rafael1193/TFG-heart-rate-monitor/img/portable-ecg.jpg

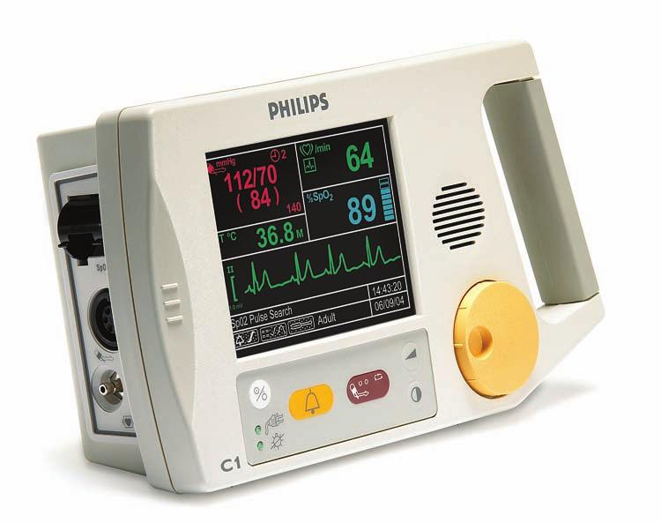
img/portable-ecg.jpg
