rafael1193/TFG-heart-rate-monitor/img/RN-42 bluetooth module-sin-fondo.jpg

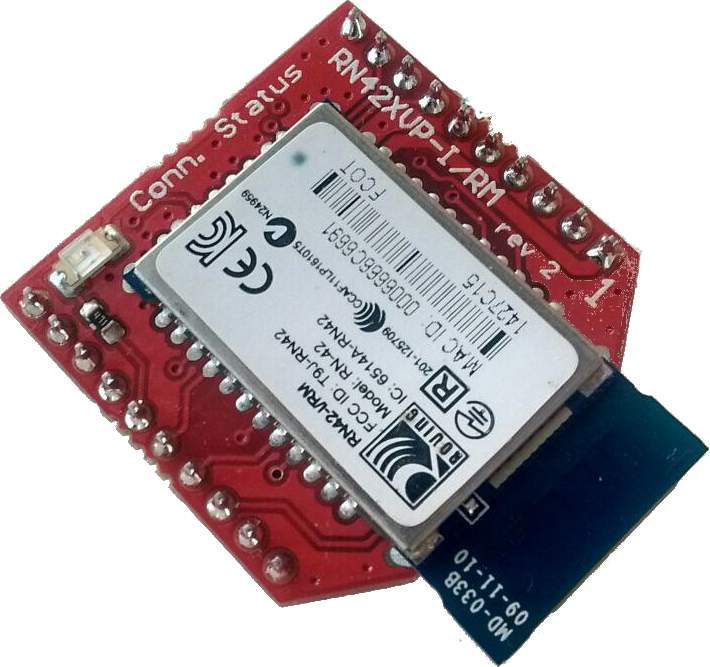
img/RN-42 bluetooth module-sin-fondo.jpg
