rafael1193/TFG-heart-rate-monitor/presentacion/presentacion.pdf

Trabajo Fin de Grado

## Diseño de un pulsómetro por infrarrojos

Rafael Bailón Ruiz

Tutor
Dr. Alberto J. Palma López

Cotutor
Fernando Martínez Martí

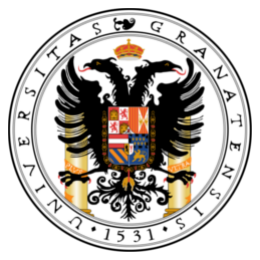
[picture p3: figure]

Departamento de Electrónica y Tecnología de Computadores Universidad de Granada

22 julio de 2015

Rafael Bailón Ruiz (UGR) | Pulsómetro por infrarrojos | 22 / 7 / 2015 | 1 / 44

## Índice

1 Introducción
2 Estado del Arte
Fundamento teórico
Medida de las pulsaciones
Dispositivos comerciales
3 Diseño y desarrollo del sistema Hardware
Firmware
Software
4 Resultados
Prueba de validación estática Prueba de validación dinámica 5 Conclusiones y trabajos futuros Conclusiones
Trabajos futuros
Rafael Bailón Ruiz (UGR) | Pulsómetro por infrarrojos | 22 / 7 / 2015 | 2 / 44

Introducción

## Conceptos clave

Rafael Bailón Ruiz (UGR) | Pulsómetro por infrarrojos | 22 / 7 / 2015 | 3 / 44

Introducción

## Conceptos clave

- Signos vitales:
- Temperatura corporal
- Frecuencia respiratoria
- Tensión arterial
- Frecuencia cardíaca
Rafael Bailón Ruiz (UGR) | Pulsómetro por infrarrojos | 22 / 7 / 2015 | 3 / 44

Introducción

## Conceptos clave

- Signos vitales:
- Temperatura corporal
- Frecuencia respiratoria
- Tensión arterial
- Frecuencia cardíaca

Pulsimetría

Método no invasivo de monitorización de la frecuencia cardíaca

Rafael Bailón Ruiz (UGR) | Pulsómetro por infrarrojos | 22 / 7 / 2015 | 3 / 44

Introducción

## Conceptos clave

- Signos vitales:
- Temperatura corporal
- Frecuencia respiratoria
- Tensión arterial
- Frecuencia cardíaca

Pulsimetría

Método no invasivo de monitorización de la frecuencia cardíaca

Fotopletismografía (PPG)

Representación de la variación volumétrica de las arterias obtenida mediante luz

Rafael Bailón Ruiz (UGR) | Pulsómetro por infrarrojos | 22 / 7 / 2015 | 3 / 44

Introducción

## Motivación

Rafael Bailón Ruiz (UGR) | Pulsómetro por infrarrojos | 22 / 7 / 2015 | 4 / 44

Introducción

## Motivación

- Aumento de las enfermedades crónicas
Rafael Bailón Ruiz (UGR) | Pulsómetro por infrarrojos | 22 / 7 / 2015 | 4 / 44

Introducción

## Motivación

- Aumento de las enfermedades crónicas
- Incremento de incidentes cardíacos inesperados
- Infarto
- Muerte súbita
Rafael Bailón Ruiz (UGR) | Pulsómetro por infrarrojos | 22 / 7 / 2015 | 4 / 44

Introducción

## Motivación

- Aumento de las enfermedades crónicas
- Incremento de incidentes cardíacos inesperados
- Infarto
- Muerte súbita
- Necesidad de monitorización fuera del recinto hospitalario (home care)
Rafael Bailón Ruiz (UGR) | Pulsómetro por infrarrojos | 22 / 7 / 2015 | 4 / 44

Introducción

## Motivación

- Aumento de las enfermedades crónicas
- Incremento de incidentes cardíacos inesperados
- Infarto
- Muerte súbita
- Necesidad de monitorización fuera del recinto hospitalario (home care)
- La instrumentación médica suele ser aparatosa y compleja de utilizar
Rafael Bailón Ruiz (UGR) | Pulsómetro por infrarrojos | 22 / 7 / 2015 | 4 / 44

Introducción

## Motivación

- Aumento de las enfermedades crónicas
- Incremento de incidentes cardíacos inesperados
- Infarto
- Muerte súbita
- Necesidad de monitorización fuera del recinto hospitalario (home care)
- La instrumentación médica suele ser aparatosa y compleja de utilizar
- Auge de los smartphones y wearable devices:
- Potencia
- Interfaz de usuario
- Conectividad
Rafael Bailón Ruiz (UGR) | Pulsómetro por infrarrojos | 22 / 7 / 2015 | 4 / 44

Introducción

## Objetivos

Rafael Bailón Ruiz (UGR) | Pulsómetro por infrarrojos | 22 / 7 / 2015 | 5 / 44

Introducción

## Objetivos

- Estudio bibliográco de las señales cardíacas y de dispositivos existentes para su medida.
Rafael Bailón Ruiz (UGR) | Pulsómetro por infrarrojos | 22 / 7 / 2015 | 5 / 44

Introducción

## Objetivos

- Estudio bibliográco de las señales cardíacas y de dispositivos existentes para su medida.
- Diseño y fabricación de un pulsómetro con sensor infrarrojo.
- Obtención del fotopletismograma.
- Procesado de la señal.
- Adquisición mediante un microcontrolador.
- Comunicación inalámbrica con un sistema monitorización.
- Diseño del sistema en placa de circuito impreso.
Rafael Bailón Ruiz (UGR) | Pulsómetro por infrarrojos | 22 / 7 / 2015 | 5 / 44

Introducción

## Objetivos

- Estudio bibliográco de las señales cardíacas y de dispositivos existentes para su medida.
- Diseño y fabricación de un pulsómetro con sensor infrarrojo.
- Obtención del fotopletismograma.
- Procesado de la señal.
- Adquisición mediante un microcontrolador.
- Comunicación inalámbrica con un sistema monitorización.
- Diseño del sistema en placa de circuito impreso.
- Diseño e implementación de una aplicación móvil para la monitorización remota del pulso cardíaco de un paciente.
Rafael Bailón Ruiz (UGR) | Pulsómetro por infrarrojos | 22 / 7 / 2015 | 5 / 44

Estado del Arte Fundamento teórico

## Índice

1 Introducción
2 Estado del Arte
Fundamento teórico
Medida de las pulsaciones
Dispositivos comerciales
3 Diseño y desarrollo del sistema Hardware
Firmware
Software
4 Resultados
Prueba de validación estática Prueba de validación dinámica 5 Conclusiones y trabajos futuros Conclusiones
Trabajos futuros
Rafael Bailón Ruiz (UGR) | Pulsómetro por infrarrojos | 22 / 7 / 2015 | 6 / 44

Estado del Arte Fundamento teórico

## Ciclo cardíaco

- Secuencia de eventos eléctricos, mecánicos, sonoros y de presión relacionados con el ujo de sangre a través de las cavidades cardíacas
Rafael Bailón Ruiz (UGR) | Pulsómetro por infrarrojos | 22 / 7 / 2015 | 7 / 44

Estado del Arte Fundamento teórico

## Ciclo cardíaco

- Secuencia de eventos eléctricos, mecánicos, sonoros y de presión relacionados con el ujo de sangre a través de las cavidades cardíacas
- Fases:
Rafael Bailón Ruiz (UGR) | Pulsómetro por infrarrojos | 22 / 7 / 2015 | 7 / 44

## Ciclo cardíaco

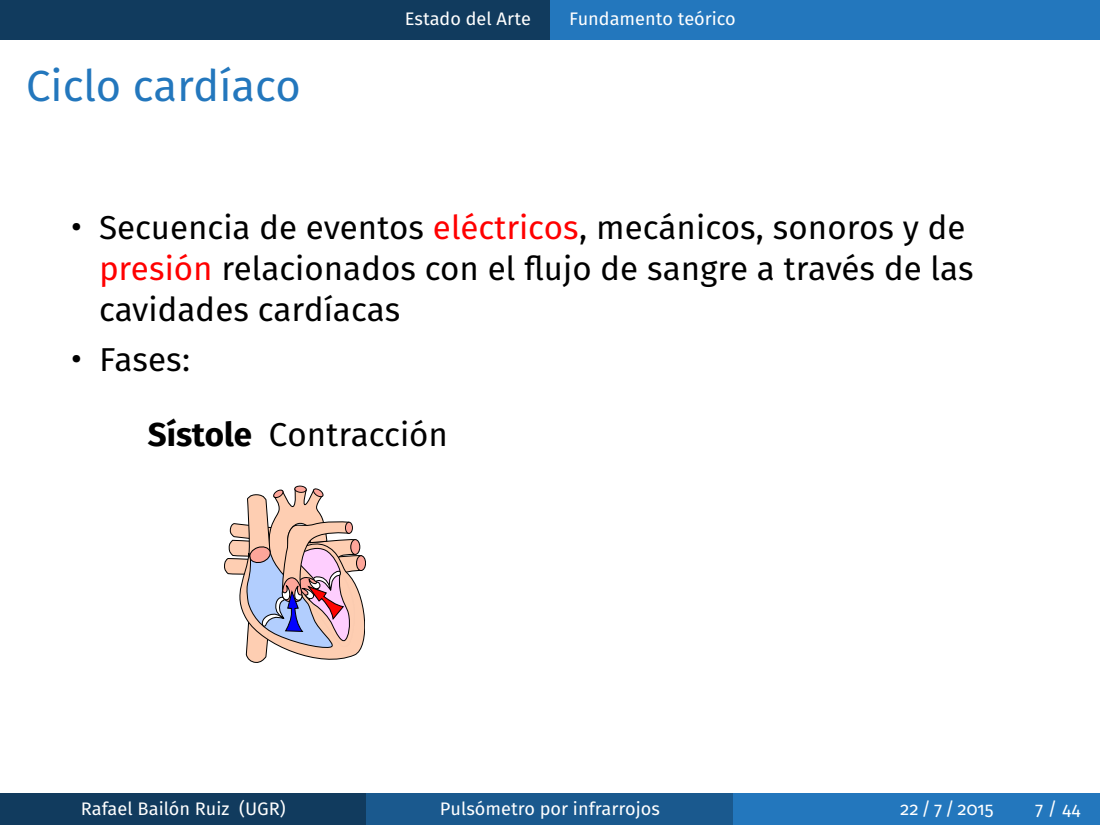
[picture p4: page 20]
Estado del Arte; Fundamento teórico; Sístole Contracción; Rafael Bailón Ruiz (UGR); Pulsómetro por infrarrojos

• Secuencia de eventos eléctricos, mecánicos, sonoros y de
presión relacionados con el ujo de sangre a través de las
cavidades cardíacas
• Fases:

## Ciclo cardíaco

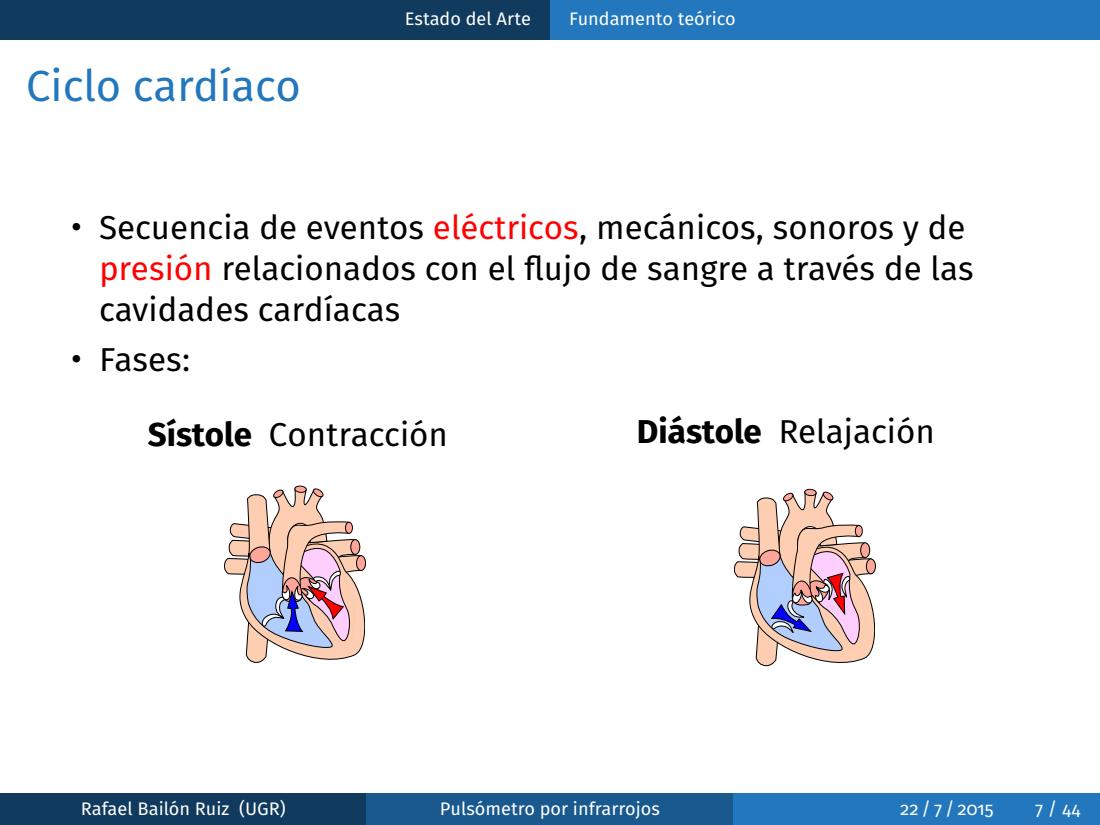
[picture p5: page 21]
Estado del Arte; Fundamento teórico; Sístole Contracción; Diástole Relajación; Rafael Bailón Ruiz (UGR); Pulsómetro por infrarrojos

• Secuencia de eventos eléctricos, mecánicos, sonoros y de
presión relacionados con el ujo de sangre a través de las
cavidades cardíacas
• Fases:

## Señales cardíacas

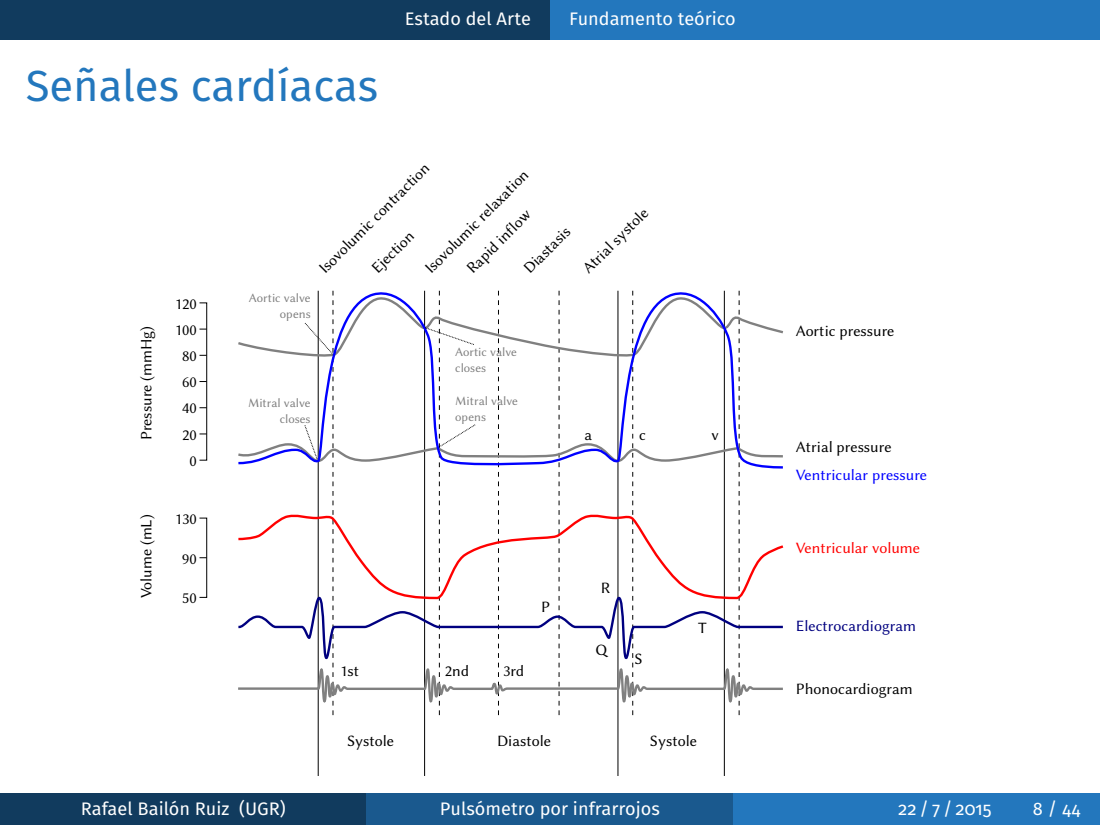
[picture p6: page 22]
Estado del Arte; Fundamento teórico; Isovolumic contraction; Ejection; Isovolumic relaxation; Rapid inflow Diastasis; Atrial systole; Aortic pressure; Atrial pressure; Ventricular pressure; Ventricular volume; Electrocardiogram; Phonocardiogram; Systole; Diastole; Pressure (mmHg); Volume (mL); Aortic valve opens; Aortic valve closes; Mitral valve closes; Mitral valve opens; Rafael Bailón Ruiz (UGR); Pulsómetro por infrarrojos

## ECG y PPG

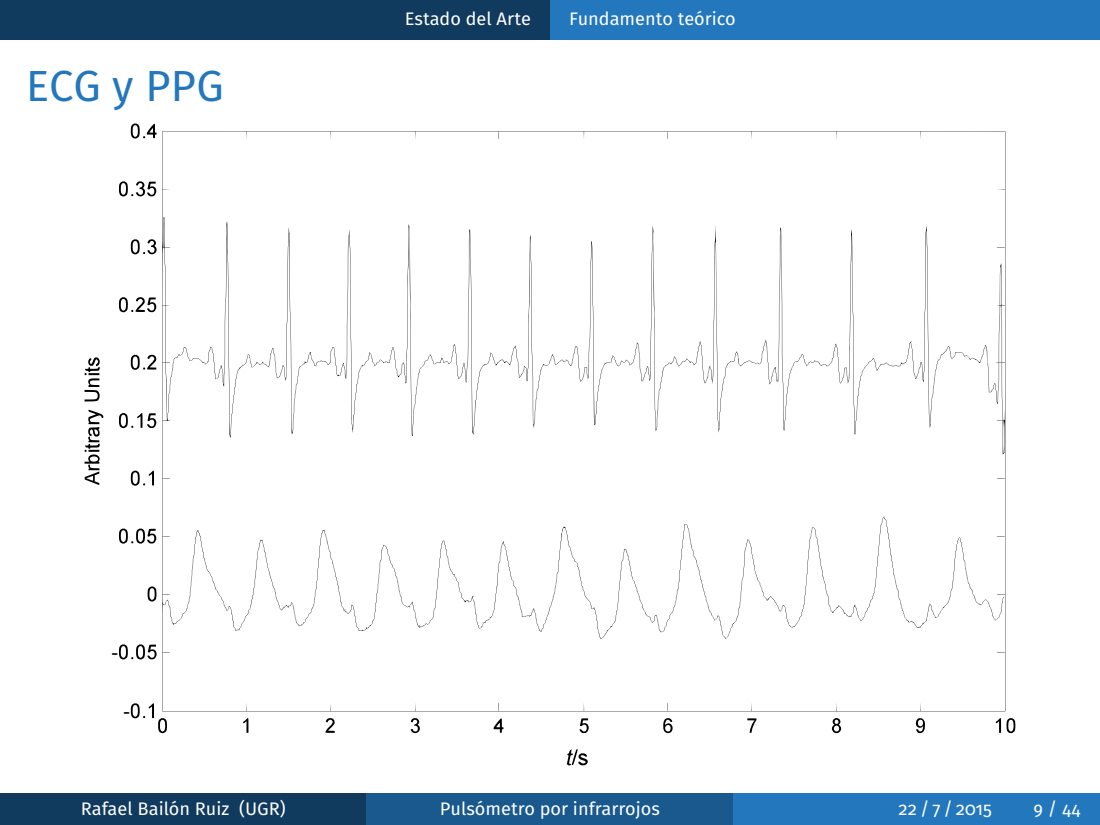
[picture p7: page 23]
Estado del Arte; Fundamento teórico; Rafael Bailón Ruiz (UGR); Pulsómetro por infrarrojos

Estado del Arte Medida de las pulsaciones

## Índice

1 Introducción
2 Estado del Arte
Fundamento teórico
Medida de las pulsaciones
Dispositivos comerciales
3 Diseño y desarrollo del sistema Hardware
Firmware
Software
4 Resultados
Prueba de validación estática Prueba de validación dinámica 5 Conclusiones y trabajos futuros Conclusiones
Trabajos futuros
Rafael Bailón Ruiz (UGR) | Pulsómetro por infrarrojos | 22 / 7 / 2015 | 10 / 44

Estado del Arte Medida de las pulsaciones

## Sensor fotopletismográco

- Registra la variación de la absorbancia de tejidos, órganos y uidos al ser iluminados
Rafael Bailón Ruiz (UGR) | Pulsómetro por infrarrojos | 22 / 7 / 2015 | 11 / 44

Estado del Arte Medida de las pulsaciones

## Sensor fotopletismográco

- Registra la variación de la absorbancia de tejidos, órganos y uidos al ser iluminados
- Compuesto por
Rafael Bailón Ruiz (UGR) | Pulsómetro por infrarrojos | 22 / 7 / 2015 | 11 / 44

Estado del Arte Medida de las pulsaciones

## Sensor fotopletismográco

- Registra la variación de la absorbancia de tejidos, órganos y uidos al ser iluminados
- Compuesto por
- Emisor: diodo
- Receptor: transistor o fotodiodo
- Rango de frecuencias: infrarrojo – rojo
Rafael Bailón Ruiz (UGR) | Pulsómetro por infrarrojos | 22 / 7 / 2015 | 11 / 44

Estado del Arte Medida de las pulsaciones

## Sensor fotopletismográco

- Registra la variación de la absorbancia de tejidos, órganos y uidos al ser iluminados
- Compuesto por
- Emisor: diodo
- Receptor: transistor o fotodiodo
- Rango de frecuencias: infrarrojo – rojo
Rafael Bailón Ruiz (UGR) | Pulsómetro por infrarrojos | 22 / 7 / 2015 | 11 / 44

Estado del Arte Medida de las pulsaciones

## Topología del sensor

Transmisión | Reexión

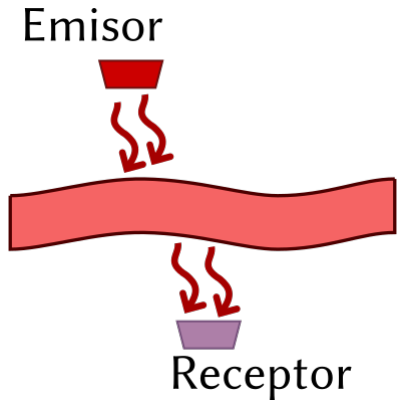
[picture p8: figure]
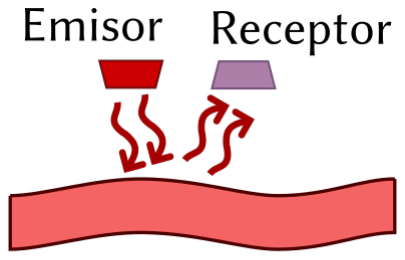
[picture p9: figure]

Rafael Bailón Ruiz (UGR) | Pulsómetro por infrarrojos | 22 / 7 / 2015 | 12 / 44

Estado del Arte Medida de las pulsaciones

## Componentes del PPG

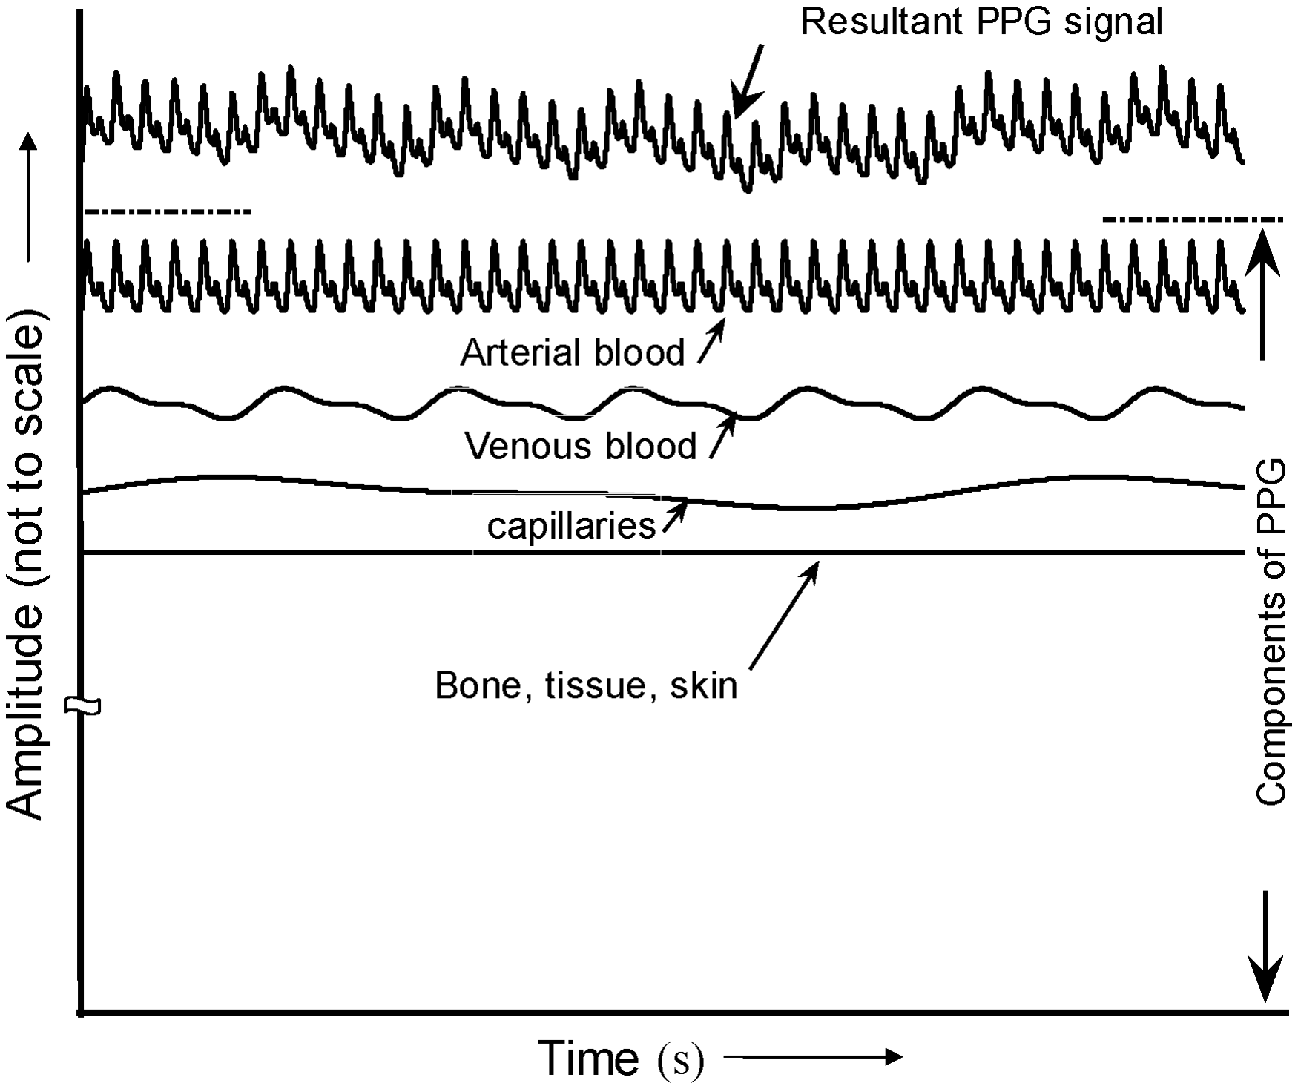
[picture p10: figure]

Rafael Bailón Ruiz (UGR) | Pulsómetro por infrarrojos | 22 / 7 / 2015 | 13 / 44

Estado del Arte Medida de las pulsaciones

## Pulsos

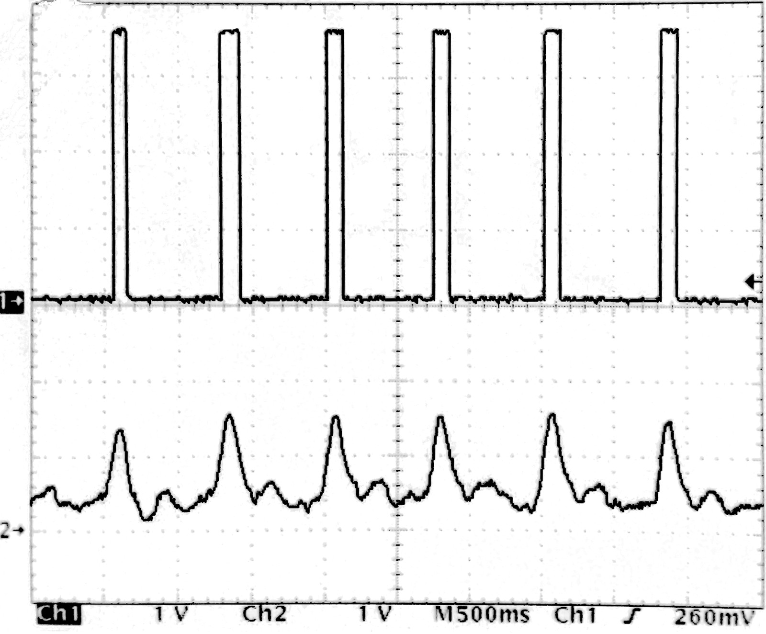
[picture p11: figure]

Rafael Bailón Ruiz (UGR) | Pulsómetro por infrarrojos | 22 / 7 / 2015 | 14 / 44

Estado del Arte Dispositivos comerciales

## Índice

1 Introducción
2 Estado del Arte
Fundamento teórico
Medida de las pulsaciones
Dispositivos comerciales
3 Diseño y desarrollo del sistema Hardware
Firmware
Software
4 Resultados
Prueba de validación estática Prueba de validación dinámica 5 Conclusiones y trabajos futuros Conclusiones
Trabajos futuros
Rafael Bailón Ruiz (UGR) | Pulsómetro por infrarrojos | 22 / 7 / 2015 | 15 / 44

Estado del Arte Dispositivos comerciales

## Pulsómetros ECG

Monitor ECG | Cardiofrecuencímetro

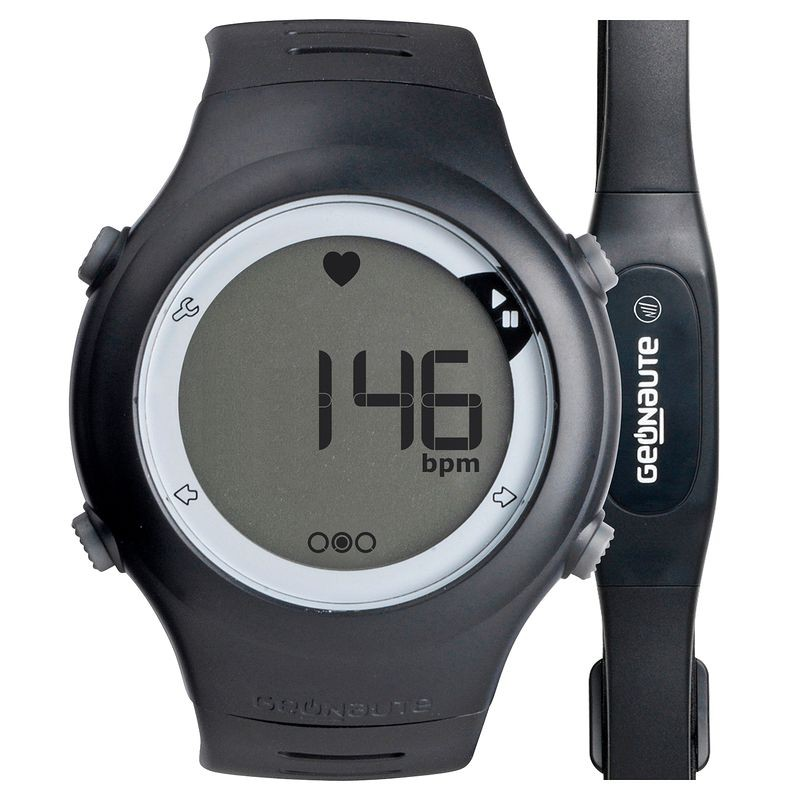
[picture p12: figure]

Rafael Bailón Ruiz (UGR) | Pulsómetro por infrarrojos | 22 / 7 / 2015 | 16 / 44

Estado del Arte Dispositivos comerciales

## Pulsómetros PPG

- Pulsera Fitbit
- FitBit Inc. >100 patentes sobre pulsómetros
vestibles
- Pulsera Samsung Gear
Fit
- Diseñada para
comunicación con
smartphone

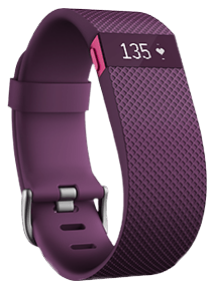
[picture p13: figure]
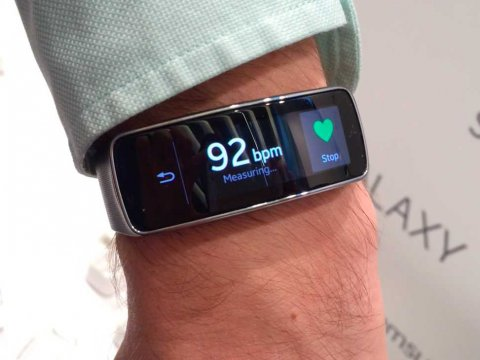
[picture p14: figure]

Rafael Bailón Ruiz (UGR) | Pulsómetro por infrarrojos | 22 / 7 / 2015 | 17 / 44

Estado del Arte Dispositivos comerciales

## Problema de los pulsómetros PPG

- Artefactos debidos al movimiento

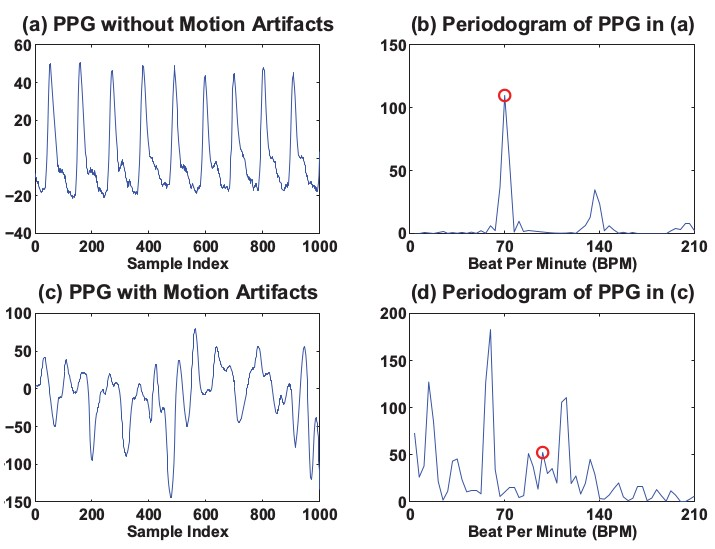
[picture p15: figure]

Rafael Bailón Ruiz (UGR) | Pulsómetro por infrarrojos | 22 / 7 / 2015 | 18 / 44

## Topología de los sensores

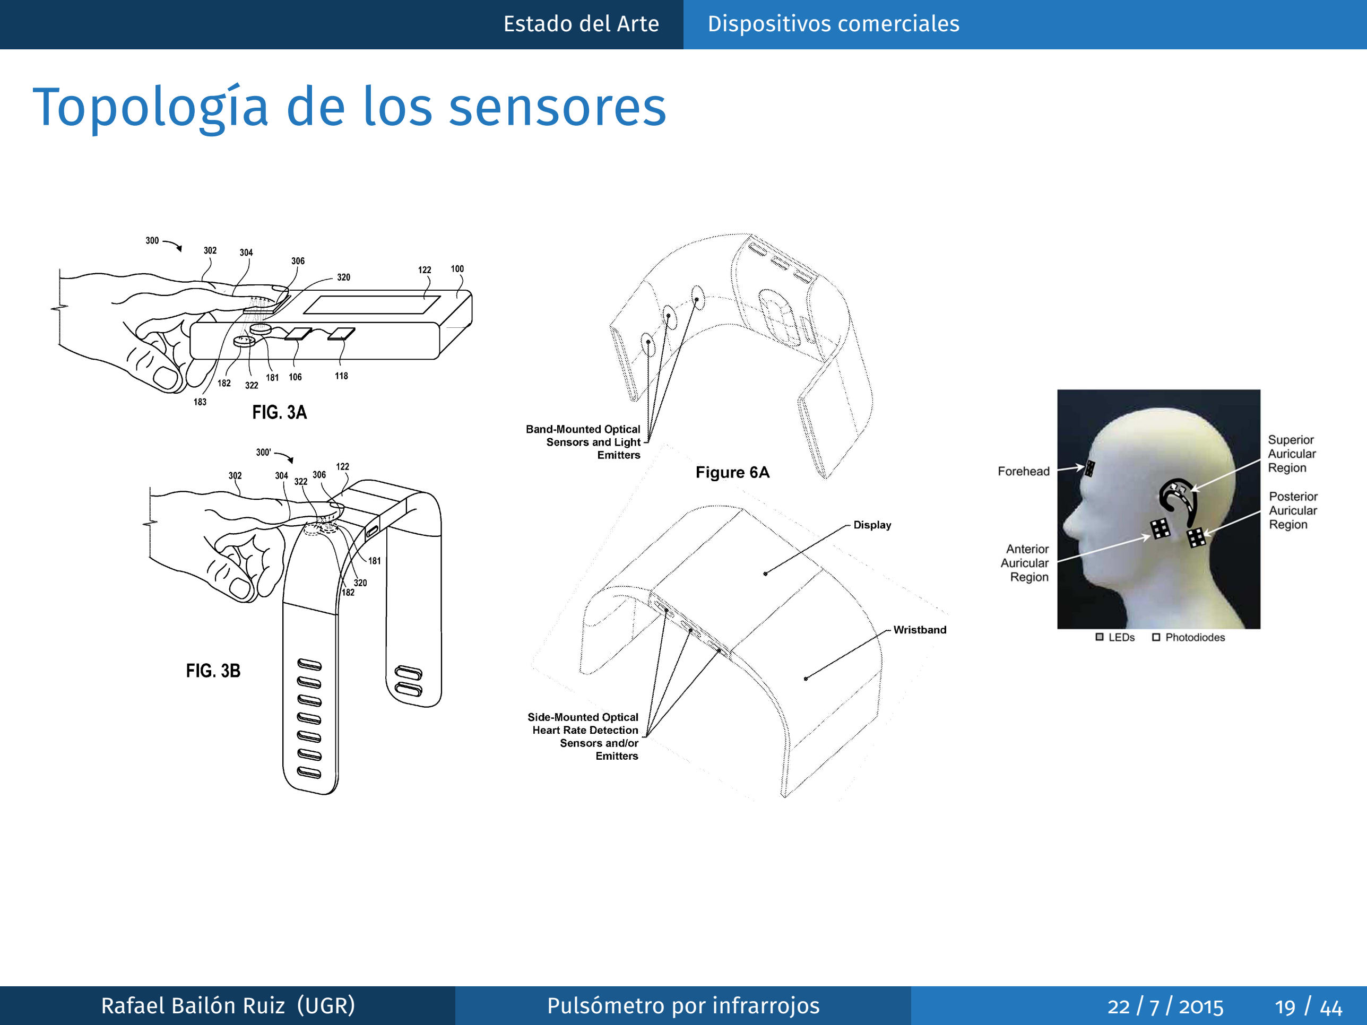
[picture p16: page 36]

Estado del Arte | Dispositivos comerciales
Rafael Bailón Ruiz (UGR) | Pulsómetro por infrarrojos | 22 / 7 / 2015 | 19 / 44

Diseño del sistema Hardware

## Índice

1 Introducción
2 Estado del Arte
Fundamento teórico
Medida de las pulsaciones
Dispositivos comerciales
3 Diseño y desarrollo del sistema Hardware
Firmware
Software
4 Resultados
Prueba de validación estática Prueba de validación dinámica 5 Conclusiones y trabajos futuros Conclusiones
Trabajos futuros
Rafael Bailón Ruiz (UGR) | Pulsómetro por infrarrojos | 22 / 7 / 2015 | 20 / 44

Diseño del sistema Hardware

## Diagrama

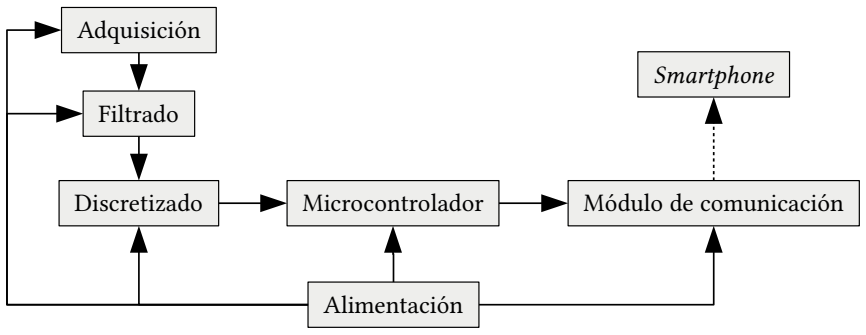
[picture p17: figure]
Discretizado; Microcontrolador; Alimentación; Módulo de comunicación; Smartphone; Adquisición; Filtrado

Rafael Bailón Ruiz (UGR) | Pulsómetro por infrarrojos | 22 / 7 / 2015 | 21 / 44

## Alimentación

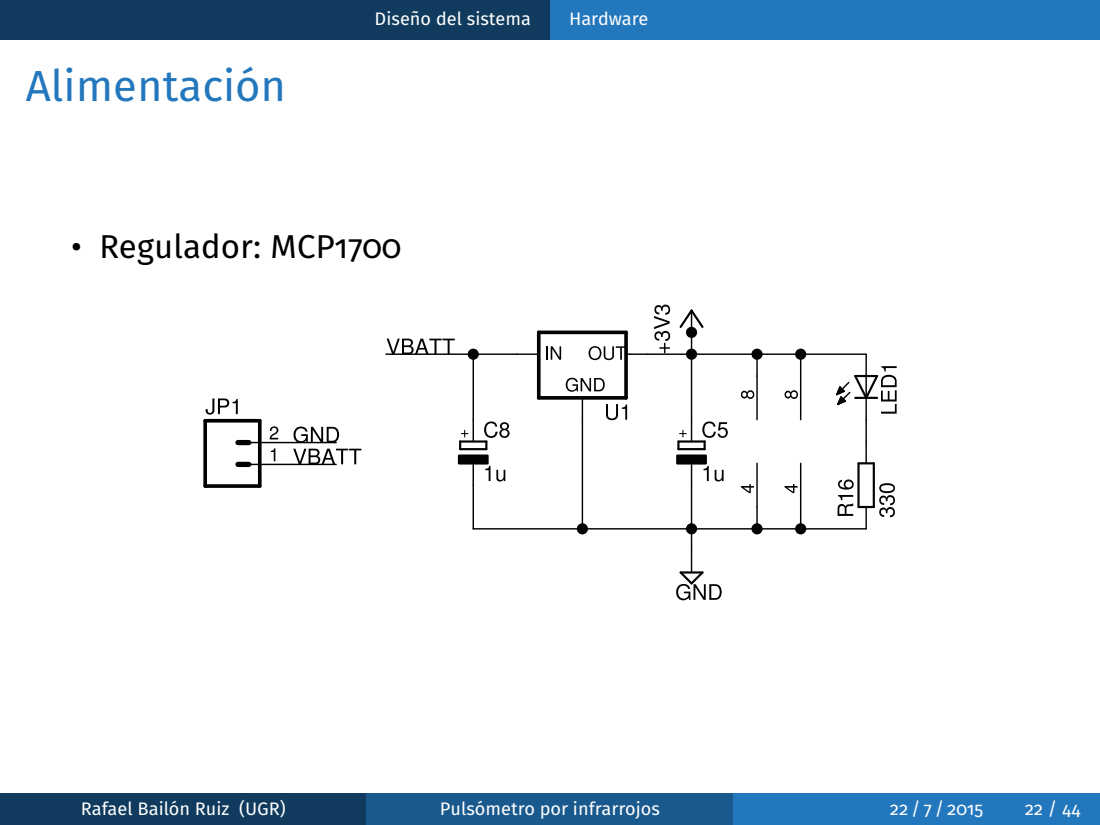
[picture p18: page 39]
Diseño del sistema; Hardware; • Regulador: MCP1700; Rafael Bailón Ruiz (UGR); Pulsómetro por infrarrojos

## Adquisición y procesado

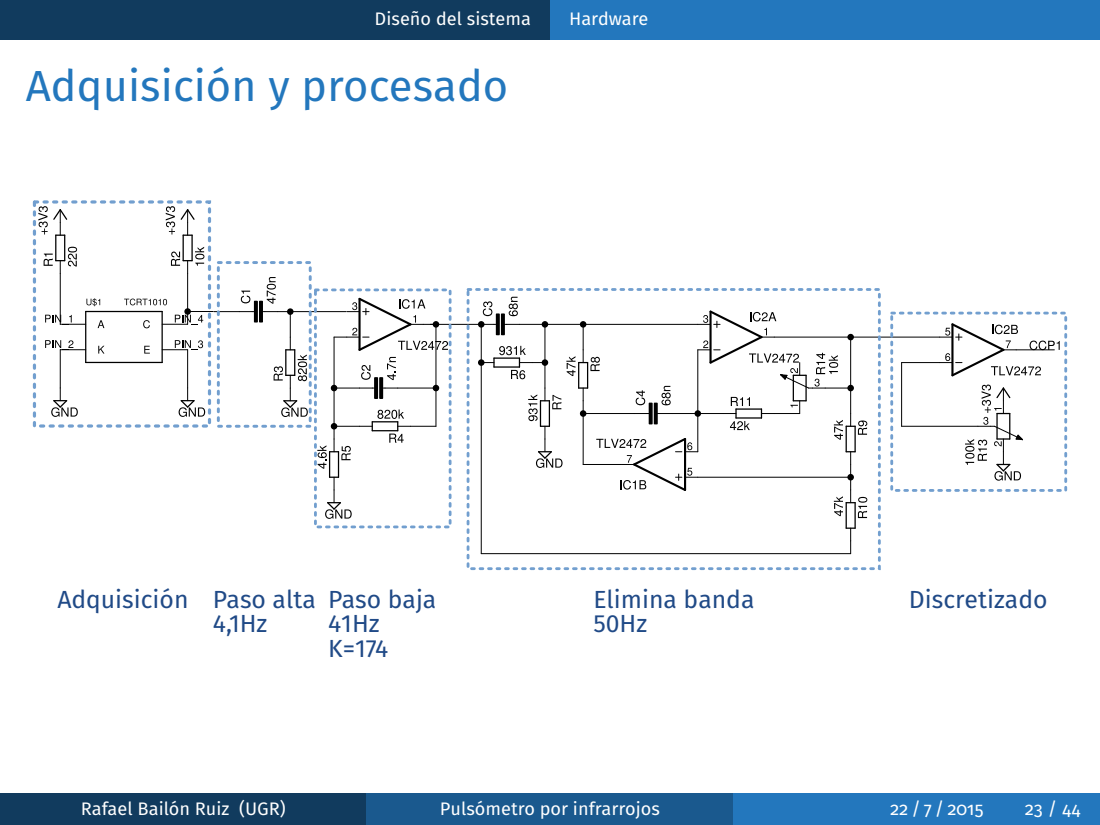
[picture p19: page 40]
Diseño del sistema; Hardware; Paso alta 4,1Hz; Paso baja 41Hz K=174; Elimina banda 50Hz; Adquisición; Discretizado; Rafael Bailón Ruiz (UGR); Pulsómetro por infrarrojos

## Microcontrolador y comunicación

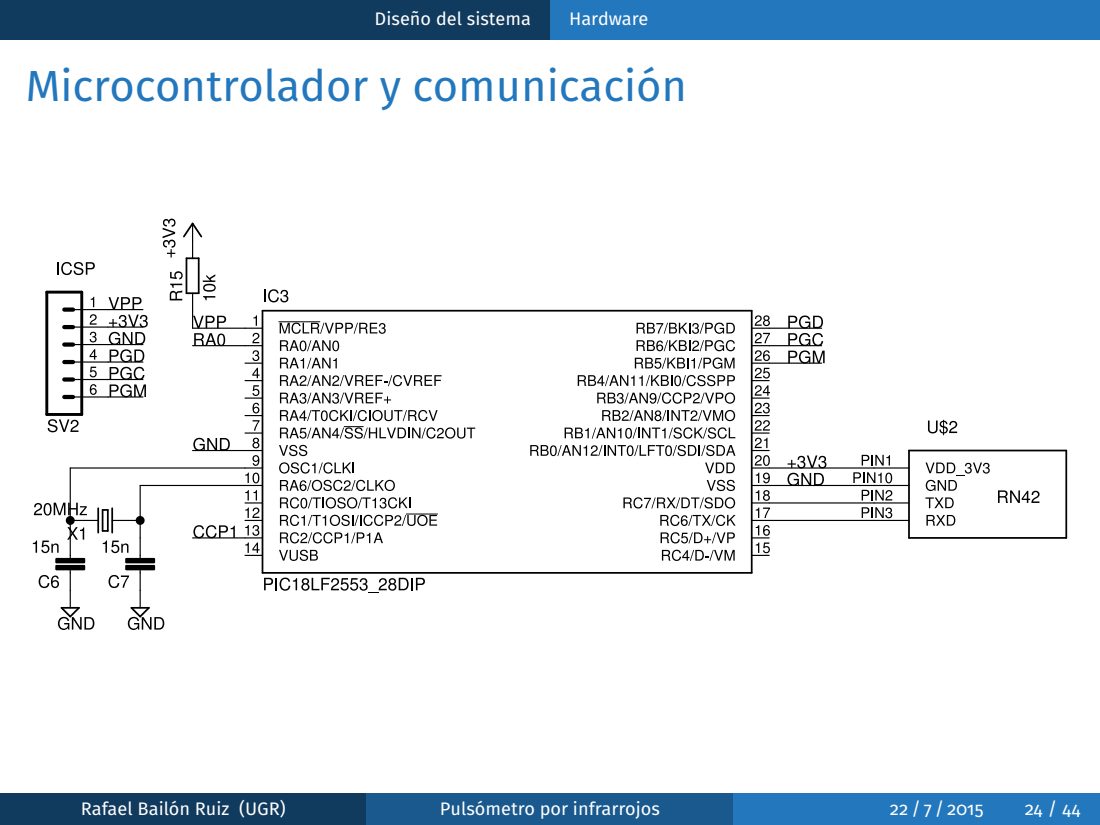
[picture p20: page 41]
Diseño del sistema; Hardware; Rafael Bailón Ruiz (UGR); Pulsómetro por infrarrojos

Diseño del sistema Firmware

## Índice

1 Introducción
2 Estado del Arte
Fundamento teórico
Medida de las pulsaciones
Dispositivos comerciales
3 Diseño y desarrollo del sistema Hardware
Firmware
Software
4 Resultados
Prueba de validación estática Prueba de validación dinámica 5 Conclusiones y trabajos futuros Conclusiones
Trabajos futuros
Rafael Bailón Ruiz (UGR) | Pulsómetro por infrarrojos | 22 / 7 / 2015 | 25 / 44

Diseño del sistema Firmware

## Manejo de interrupciones

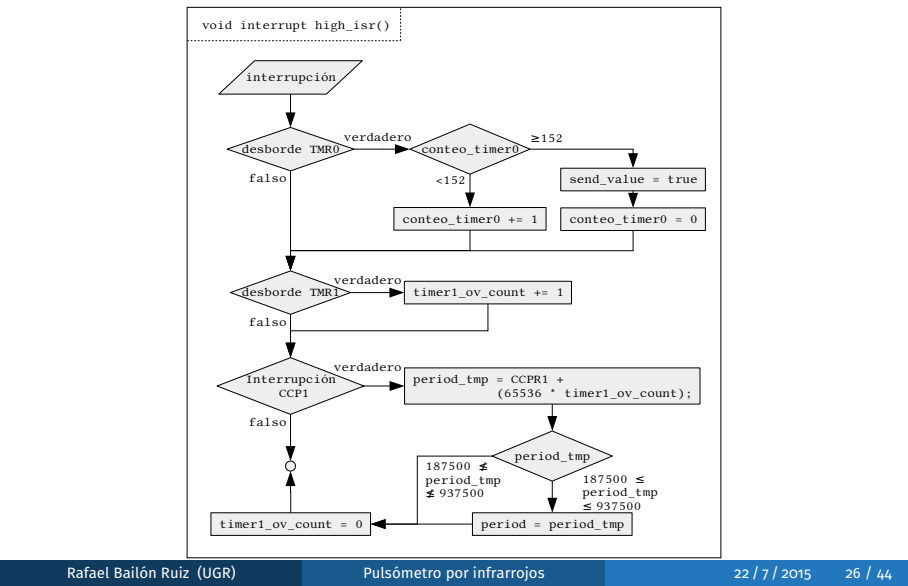
[picture p21: figure]
void interrupt high_isr(); desborde TMR0; verdadero; falso; desborde TMR1; Interrupción CCP1; conteo_timer0; send_value = true; conteo_timer0 = 0; interrupción; conteo_timer0 += 1; timer1_ov_count += 1; period_tmp = CCPR1 + (65536 * timer1_ov_count);; timer1_ov_count = 0; period_tmp; period = period_tmp; 187500 ≤ period_tmp ≤ 937500; 187500 ≰ period_tmp ≰ 937500; Rafael Bailón Ruiz (UGR); Pulsómetro por infrarrojos

Diseño del sistema Firmware

## Función principal

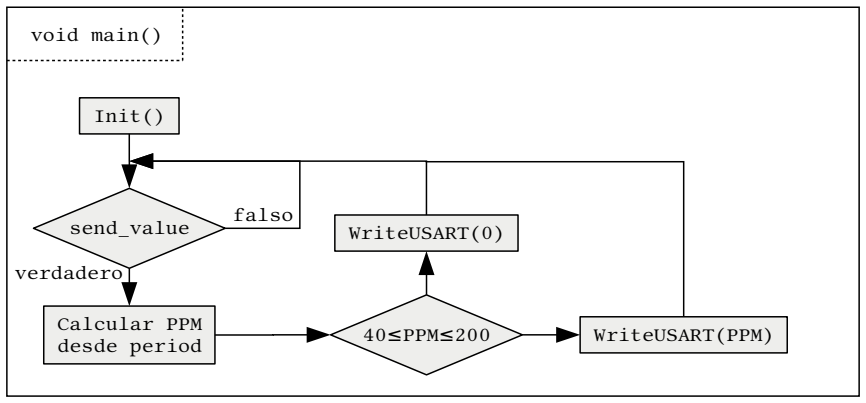
[picture p22: figure]
void main(); Init(); send_value; Calcular PPM; desde period; 40≤PPM≤200; WriteUSART(PPM); WriteUSART(0); verdadero; falso

Rafael Bailón Ruiz (UGR) | Pulsómetro por infrarrojos | 22 / 7 / 2015 | 27 / 44

Diseño del sistema Software

## Índice

1 Introducción
2 Estado del Arte
Fundamento teórico
Medida de las pulsaciones
Dispositivos comerciales
3 Diseño y desarrollo del sistema Hardware
Firmware
Software
4 Resultados
Prueba de validación estática Prueba de validación dinámica 5 Conclusiones y trabajos futuros Conclusiones
Trabajos futuros
Rafael Bailón Ruiz (UGR) | Pulsómetro por infrarrojos | 22 / 7 / 2015 | 28 / 44

## Aplicación Android

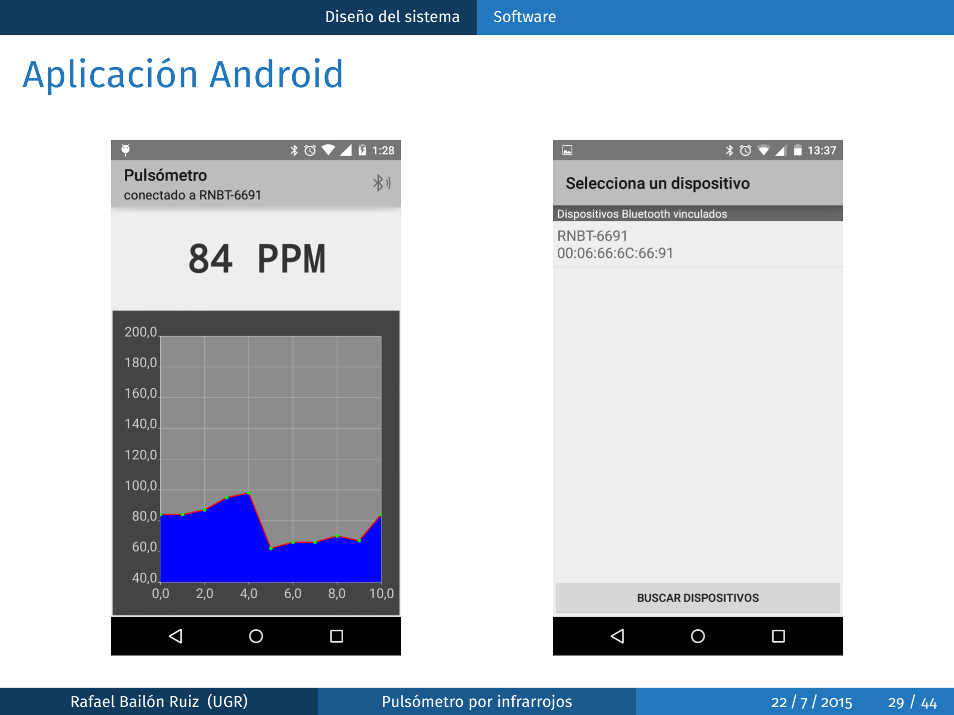
[picture p23: page 46]

Diseño del sistema | Software
Rafael Bailón Ruiz (UGR) | Pulsómetro por infrarrojos | 22 / 7 / 2015 | 29 / 44

Resultados

## Pulsómetro en funcionamiento

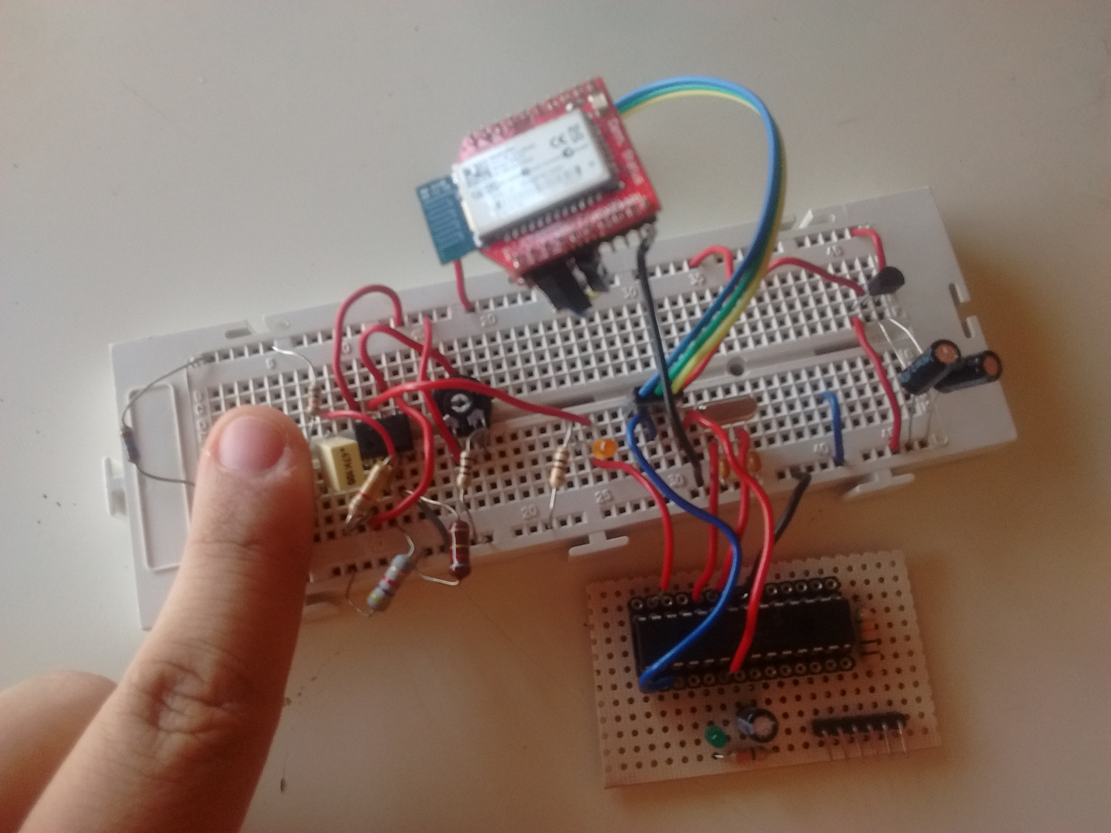
[picture p24: figure]

Rafael Bailón Ruiz (UGR) | Pulsómetro por infrarrojos | 22 / 7 / 2015 | 30 / 44

Resultados Prueba estática

## Índice

1 Introducción
2 Estado del Arte
Fundamento teórico
Medida de las pulsaciones
Dispositivos comerciales
3 Diseño y desarrollo del sistema Hardware
Firmware
Software
4 Resultados
Prueba de validación estática Prueba de validación dinámica 5 Conclusiones y trabajos futuros Conclusiones
Trabajos futuros
Rafael Bailón Ruiz (UGR) | Pulsómetro por infrarrojos | 22 / 7 / 2015 | 31 / 44

Resultados Prueba estática

## Condiciones de test

Rafael Bailón Ruiz (UGR) | Pulsómetro por infrarrojos | 22 / 7 / 2015 | 32 / 44

Resultados Prueba estática

## Condiciones de test

- Toma de pulsaciones en reposo
Rafael Bailón Ruiz (UGR) | Pulsómetro por infrarrojos | 22 / 7 / 2015 | 32 / 44

Resultados Prueba estática

## Condiciones de test

- Toma de pulsaciones en reposo
- Sujeto:
- Varón
- Atleta veterano
- 54 años
Rafael Bailón Ruiz (UGR) | Pulsómetro por infrarrojos | 22 / 7 / 2015 | 32 / 44

Resultados Prueba estática

## Condiciones de test

- Toma de pulsaciones en reposo
- Sujeto:
- Varón
- Atleta veterano
- 54 años
- Validación de los datos:
- Comparación con cardiofrecuencímetro comercial basado en ECG
Rafael Bailón Ruiz (UGR) | Pulsómetro por infrarrojos | 22 / 7 / 2015 | 32 / 44

Resultados Prueba estática

## Resultados

Pulsómetro | Cardiofrecuencímetro
Promedio pulsaciones [PPM] | 70 | 69
Desviación estándar | 4,01 | 1,90
g | 8 | 8
n | 9 | 9
t student (0,9950) | 3,355 | 3,355
Error absoluto | ±4,49 | ±2,12
Rafael Bailón Ruiz (UGR) | Pulsómetro por infrarrojos | 22 / 7 / 2015 | 33 / 44

Resultados Prueba dinámica

## Índice

1 Introducción
2 Estado del Arte
Fundamento teórico
Medida de las pulsaciones
Dispositivos comerciales
3 Diseño y desarrollo del sistema Hardware
Firmware
Software
4 Resultados
Prueba de validación estática Prueba de validación dinámica 5 Conclusiones y trabajos futuros Conclusiones
Trabajos futuros
Rafael Bailón Ruiz (UGR) | Pulsómetro por infrarrojos | 22 / 7 / 2015 | 34 / 44

Resultados Prueba dinámica

## Condiciones de test

- Toma de pulsaciones durante el periodo de recuperación tras sesión de ejercicio
Rafael Bailón Ruiz (UGR) | Pulsómetro por infrarrojos | 22 / 7 / 2015 | 35 / 44

Resultados Prueba dinámica

## Condiciones de test

- Toma de pulsaciones durante el periodo de recuperación tras sesión de ejercicio
- Sujeto:
- Varón
- Atleta veterano
- 54 años
Rafael Bailón Ruiz (UGR) | Pulsómetro por infrarrojos | 22 / 7 / 2015 | 35 / 44

Resultados Prueba dinámica

## Condiciones de test

- Toma de pulsaciones durante el periodo de recuperación tras sesión de ejercicio
- Sujeto:
- Varón
- Atleta veterano
- 54 años
- Validación de los datos:
- Comparación con cardiofrecuencímetro comercial basado en ECG
Rafael Bailón Ruiz (UGR) | Pulsómetro por infrarrojos | 22 / 7 / 2015 | 35 / 44

Resultados Prueba dinámica

## Resultados

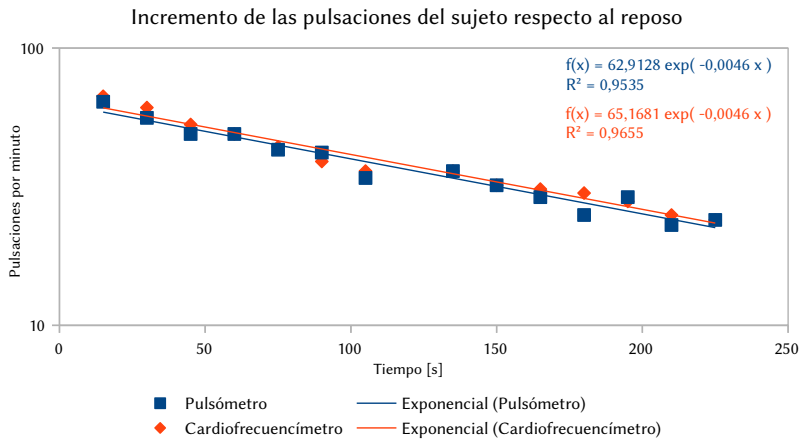
[picture p25: figure]
f(x) = 65,1681 exp( -0,0046 x ) R² = 0,9655; f(x) = 62,9128 exp( -0,0046 x ) R² = 0,9535; Pulsómetro; Exponencial (Pulsómetro); Cardiofrecuencímetro; Exponencial (Cardiofrecuencímetro); Tiempo [s]; Pulsaciones por minuto

Incremento de las pulsaciones del sujeto respecto al reposo

Rafael Bailón Ruiz (UGR) | Pulsómetro por infrarrojos | 22 / 7 / 2015 | 36 / 44

Resultados Prueba dinámica

## Resultados

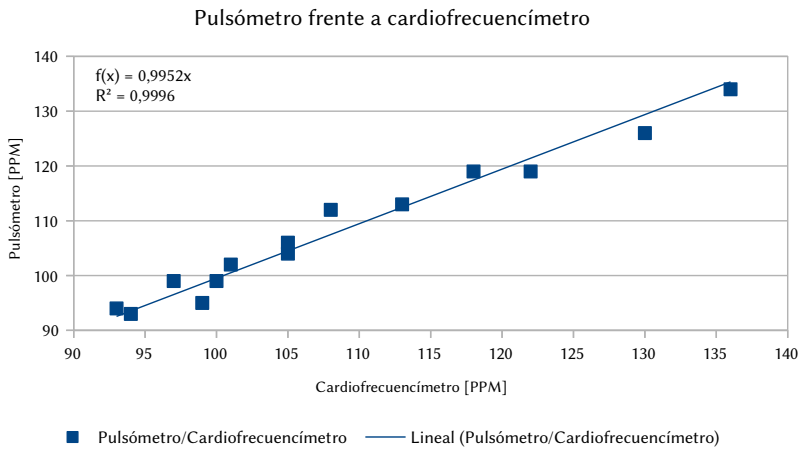
[picture p26: figure]
Pulsómetro frente a cardiofrecuencímetro; Pulsómetro/Cardiofrecuencímetro; Lineal (Pulsómetro/Cardiofrecuencímetro); Cardiofrecuencímetro [PPM]; Pulsómetro [PPM]

Rafael Bailón Ruiz (UGR) | Pulsómetro por infrarrojos | 22 / 7 / 2015 | 37 / 44

Conclusiones y trabajos futuros Conclusiones

## Índice

1 Introducción
2 Estado del Arte
Fundamento teórico
Medida de las pulsaciones
Dispositivos comerciales
3 Diseño y desarrollo del sistema Hardware
Firmware
Software
4 Resultados
Prueba de validación estática Prueba de validación dinámica 5 Conclusiones y trabajos futuros Conclusiones
Trabajos futuros
Rafael Bailón Ruiz (UGR) | Pulsómetro por infrarrojos | 22 / 7 / 2015 | 38 / 44

Conclusiones y trabajos futuros Conclusiones

## Conclusiones

- El estudio del estado del arte ha revelado las posibilidades de la pulsimetría basada en PPG
Rafael Bailón Ruiz (UGR) | Pulsómetro por infrarrojos | 22 / 7 / 2015 | 39 / 44

Conclusiones y trabajos futuros Conclusiones

## Conclusiones

- El estudio del estado del arte ha revelado las posibilidades de la pulsimetría basada en PPG
- La comunicación inalámbrica y los smartphones facilitan el uso de la instrumentación médica
Rafael Bailón Ruiz (UGR) | Pulsómetro por infrarrojos | 22 / 7 / 2015 | 39 / 44

Conclusiones y trabajos futuros Conclusiones

## Conclusiones

- El estudio del estado del arte ha revelado las posibilidades de la pulsimetría basada en PPG
- La comunicación inalámbrica y los smartphones facilitan el uso de la instrumentación médica
- Comprobación del funcionamiento del pulsómetro diseñado
Rafael Bailón Ruiz (UGR) | Pulsómetro por infrarrojos | 22 / 7 / 2015 | 39 / 44

Conclusiones y trabajos futuros Trabajos futuros

## Índice

1 Introducción
2 Estado del Arte
Fundamento teórico
Medida de las pulsaciones
Dispositivos comerciales
3 Diseño y desarrollo del sistema Hardware
Firmware
Software
4 Resultados
Prueba de validación estática Prueba de validación dinámica 5 Conclusiones y trabajos futuros Conclusiones
Trabajos futuros
Rafael Bailón Ruiz (UGR) | Pulsómetro por infrarrojos | 22 / 7 / 2015 | 40 / 44

Conclusiones y trabajos futuros Trabajos futuros

## Trabajos futuros

- Pasar del montaje experimental al producto nal
Rafael Bailón Ruiz (UGR) | Pulsómetro por infrarrojos | 22 / 7 / 2015 | 41 / 44

Conclusiones y trabajos futuros Trabajos futuros

## Trabajos futuros

- Pasar del montaje experimental al producto nal
- Mejorar la topología del sensor fotopletismográco
Rafael Bailón Ruiz (UGR) | Pulsómetro por infrarrojos | 22 / 7 / 2015 | 41 / 44

Conclusiones y trabajos futuros Trabajos futuros

## Trabajos futuros

- Pasar del montaje experimental al producto nal
- Mejorar la topología del sensor fotopletismográco
- Ampliar funcionalidad de la aplicación
- Portar a otros sistema operativos
- Más opciones de conguración y personalización
Rafael Bailón Ruiz (UGR) | Pulsómetro por infrarrojos | 22 / 7 / 2015 | 41 / 44

Apéndice Bibliografía fundamental

## Referencias I

Ramlee, R.A. et al.
Low cost heart rate monitoring device using Bluetooth 2014 2nd International Conference on Information and Communication Technology (ICoICT). 42–46, 2014.

Venkatraman, S.
Wearable heart rate monitor
United States Patent: 8945017. February 3, 2015.

Zhang, Z.
Heart rate monitoring from wrist-type photoplethysmographic (PPG) signals during intensive physical exercise
2014 IEEE Global Conference on Signal and Information Processing (GlobalSIP). 698–702, 2014.
Rafael Bailón Ruiz (UGR) | Pulsómetro por infrarrojos | 22 / 7 / 2015 | 42 / 44

Apéndice Bibliografía fundamental

## Referencias II

1
Thesis Defense de Randall Munroe traducido por Gabriel Rodríguez Alberich, disponible bajo la licencia CC BY-NC 2.0 http://es.xkcd.com/strips/defensa-de-tesis/

Referencias a las imágenes y diagramas en la memoria.

Rafael Bailón Ruiz (UGR) | Pulsómetro por infrarrojos | 22 / 7 / 2015 | 43 / 44

Apéndice Final

## ¡Gracias por su atención!

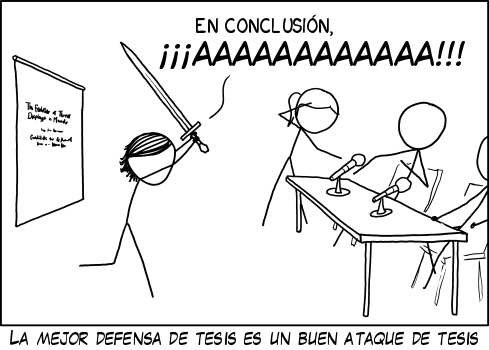
[picture p27: figure]

1

Contenido disponible en
https://github.com/rafael1193/TFG-heart-rate-monitor
Rafael Bailón Ruiz (UGR) | Pulsómetro por infrarrojos | 22 / 7 / 2015 | 44 / 44
