rafael1193/TFG-heart-rate-monitor/img/app-activar_bluetooth.png

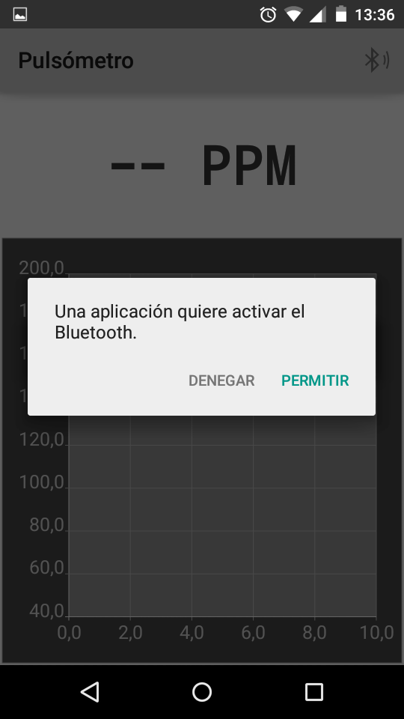
img/app-activar_bluetooth.png
