rafael1193/TFG-heart-rate-monitor/img/app-buscando.png

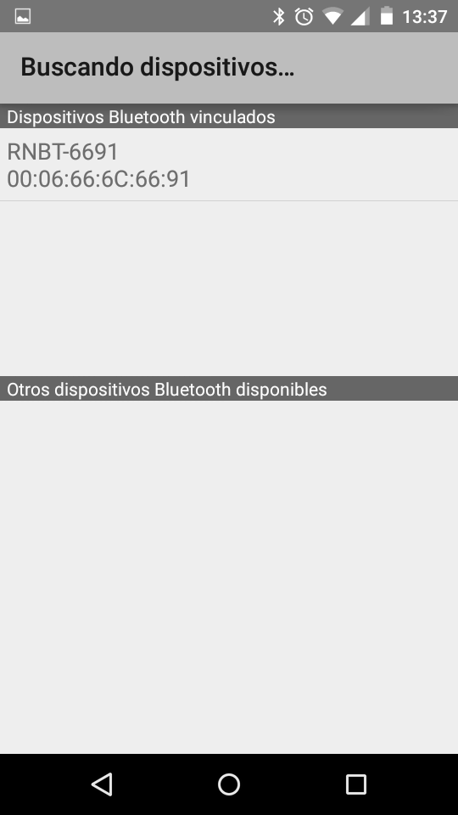
img/app-buscando.png
