rafael1193/TFG-heart-rate-monitor/img/app-midiendo.png

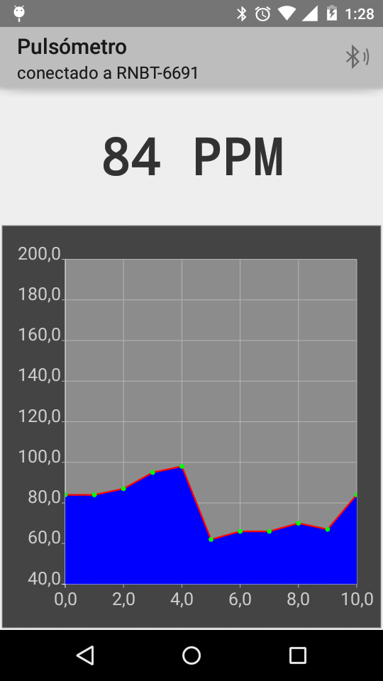
img/app-midiendo.png
