rafael1193/TFG-heart-rate-monitor/img/app-midiendo_sin_promedio.png

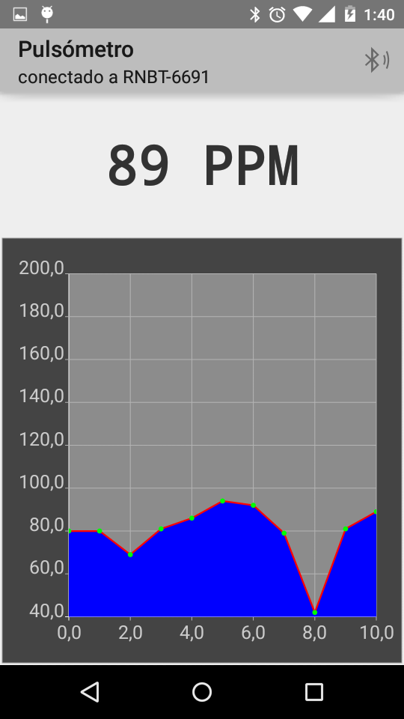
img/app-midiendo_sin_promedio.png
