rafael1193/TFG-heart-rate-monitor/img/app-no_encontrados.png

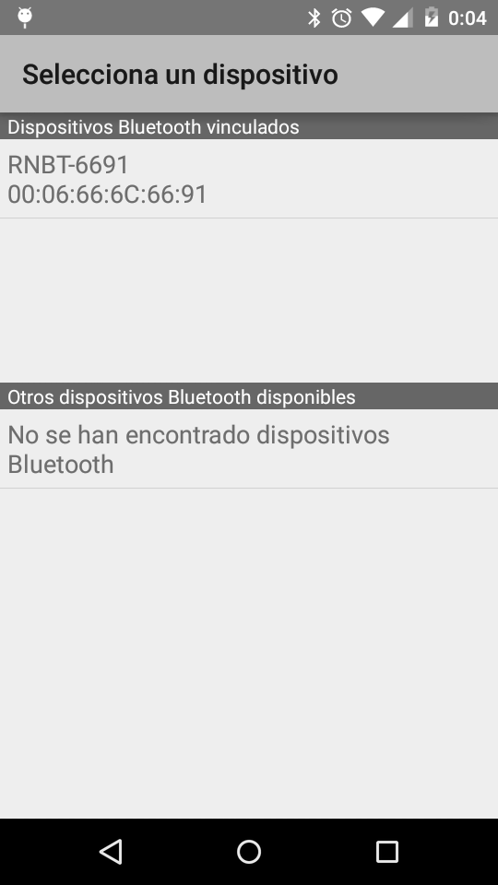
img/app-no_encontrados.png
