rafael1193/TFG-heart-rate-monitor/img/app-vista_bluetooth.png

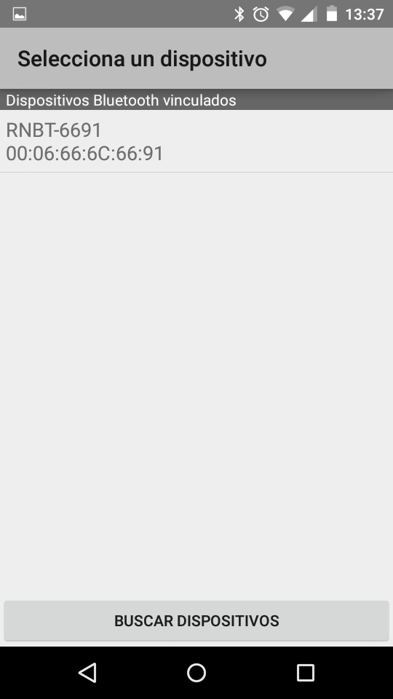
img/app-vista_bluetooth.png
