rafael1193/TFG-heart-rate-monitor/img/apple-watch.jpg

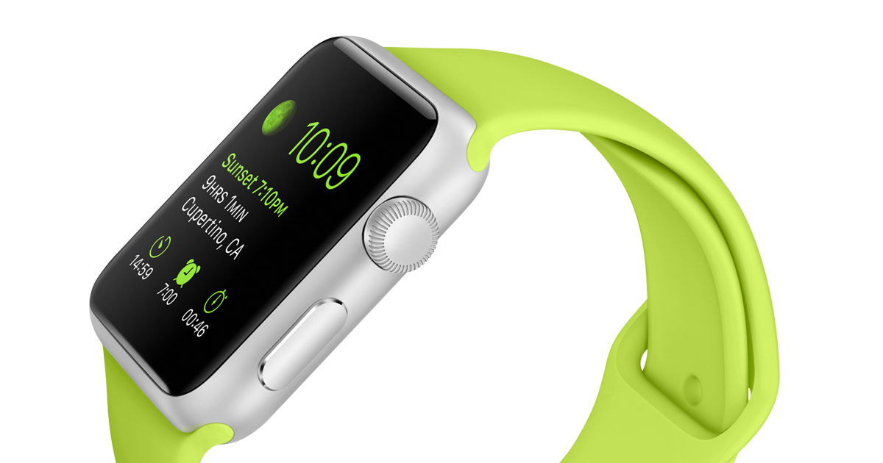
img/apple-watch.jpg
