rafael1193/TFG-heart-rate-monitor/img/BP-400.jpg

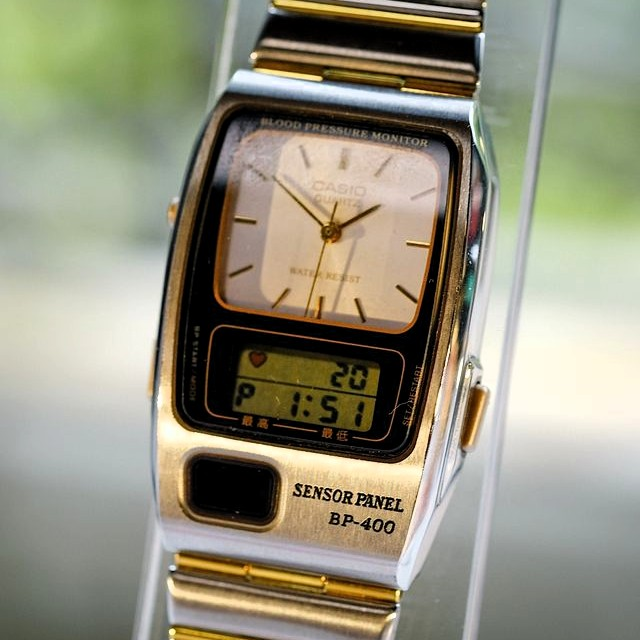
img/BP-400.jpg
