rafael1193/TFG-heart-rate-monitor/img/ECG-y-PPG-González-Landaeta.png

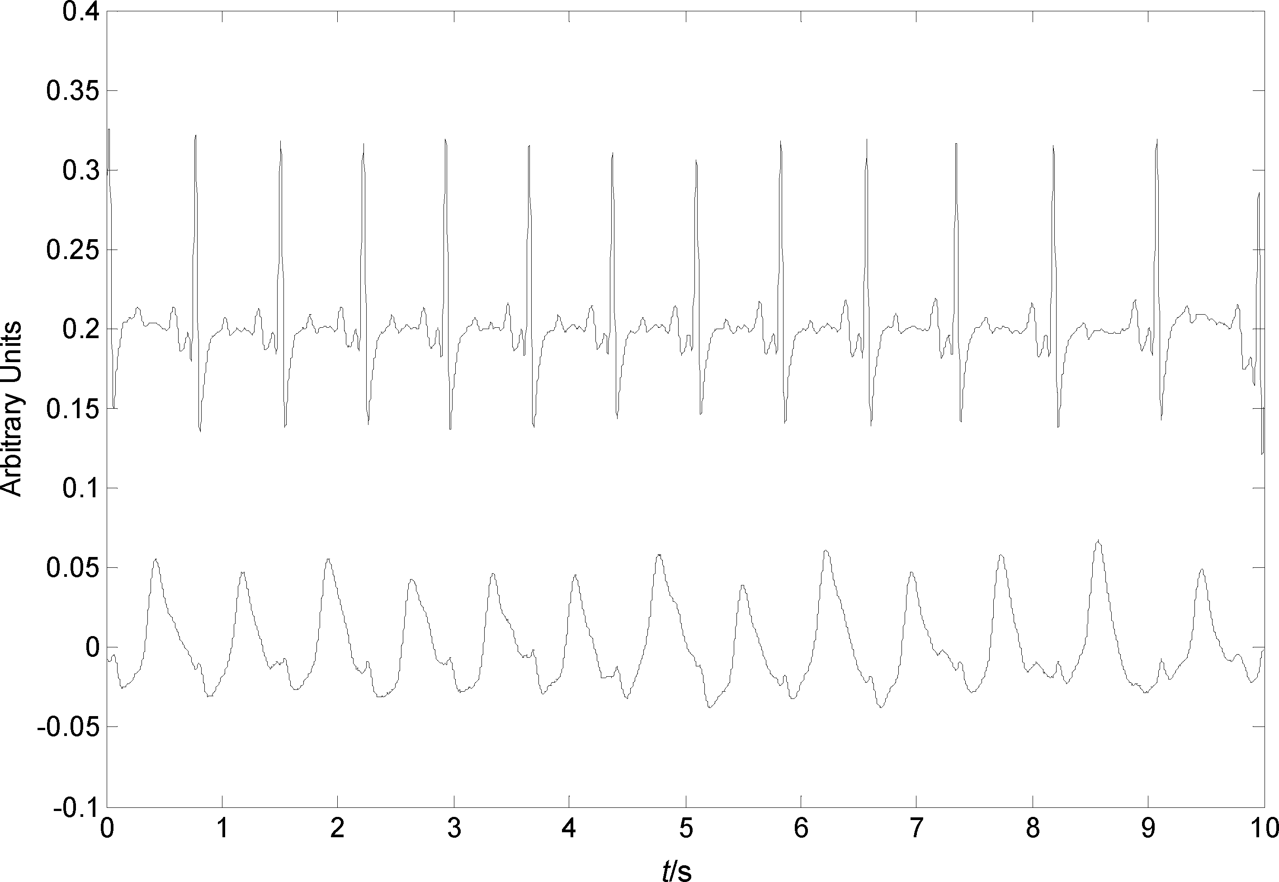
img/ECG-y-PPG-González-Landaeta.png
