rafael1193/TFG-heart-rate-monitor/img/PPG-oreja.jpg

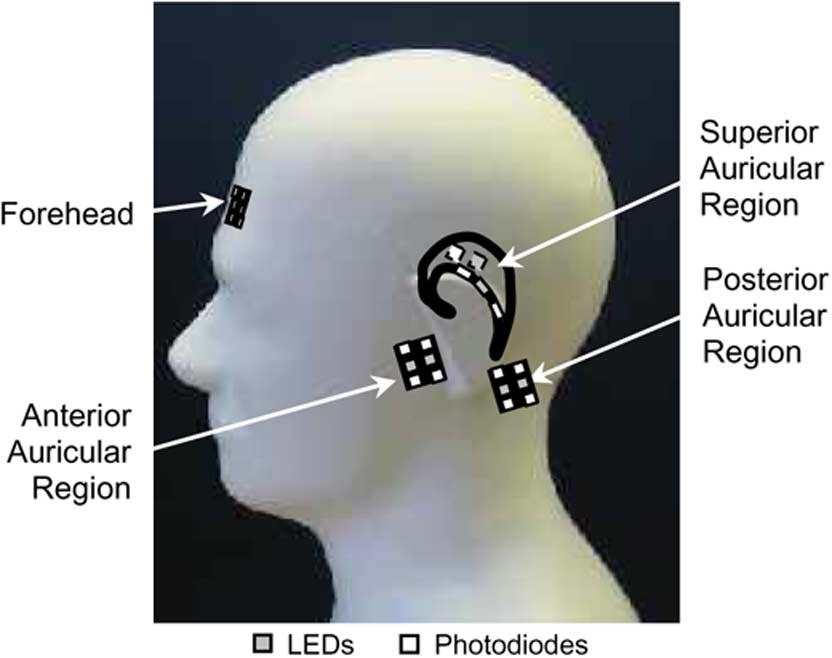
img/PPG-oreja.jpg
