rafael1193/TFG-heart-rate-monitor/img/pulsos.jpg

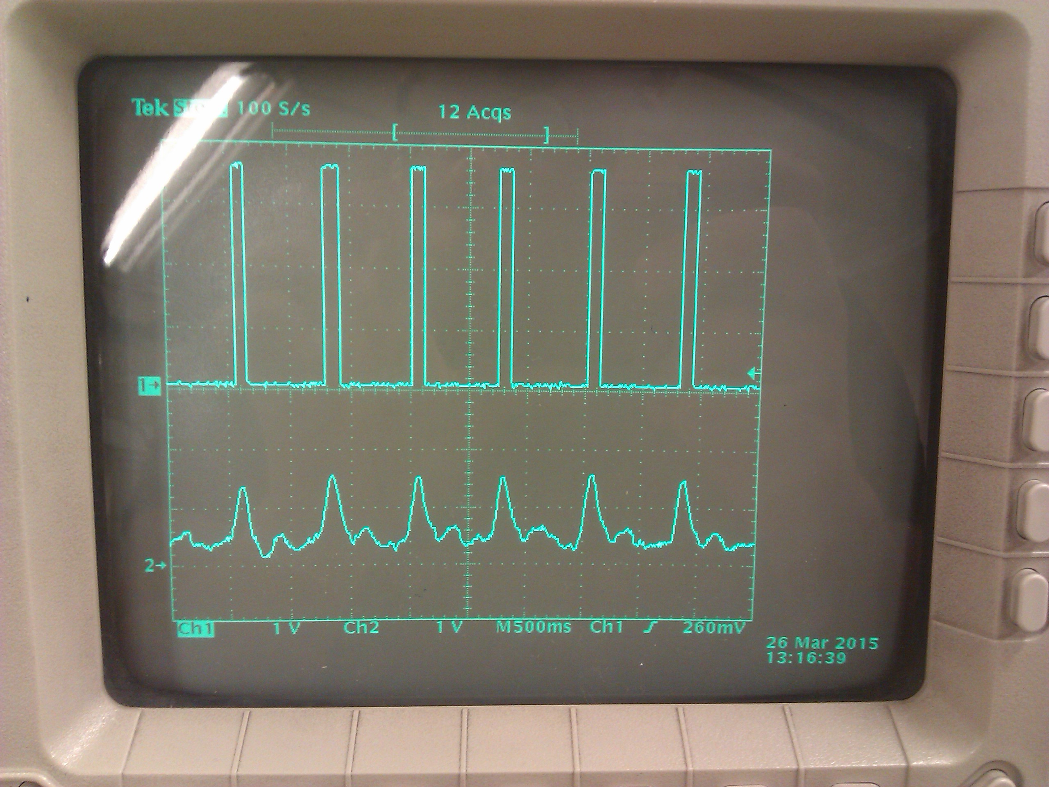
img/pulsos.jpg
