rafael1193/TFG-heart-rate-monitor/img/reflexion.png

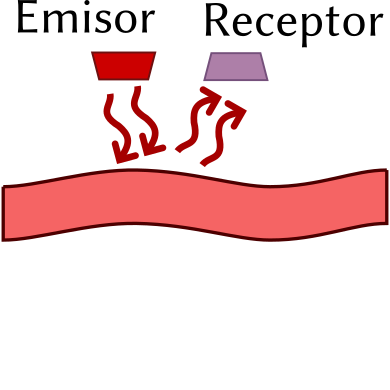
img/reflexion.png
