rafael1193/TFG-heart-rate-monitor/img/Stethoscope-bn.jpg

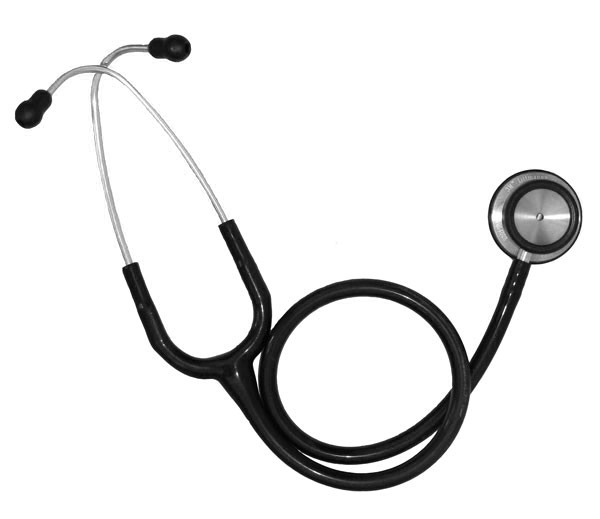
img/Stethoscope-bn.jpg
