rafael1193/TFG-heart-rate-monitor/img/TCRT1010-sin-fondo.jpg

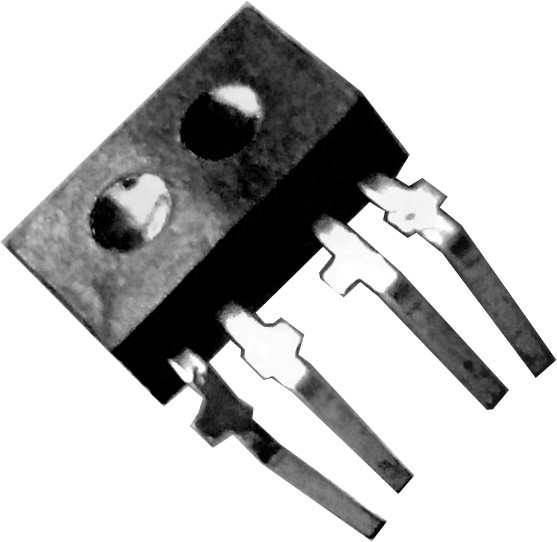
img/TCRT1010-sin-fondo.jpg
