rafael1193/TFG-heart-rate-monitor/img/TCRT1010.jpg

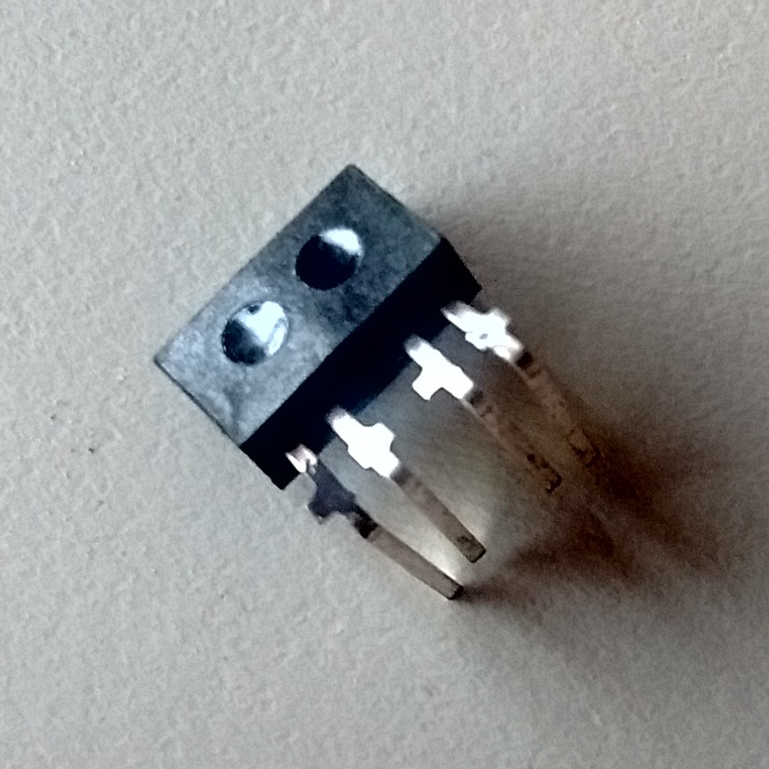
img/TCRT1010.jpg
