rafael1193/TFG-heart-rate-monitor/img/US-patent-9014790-9.jpg

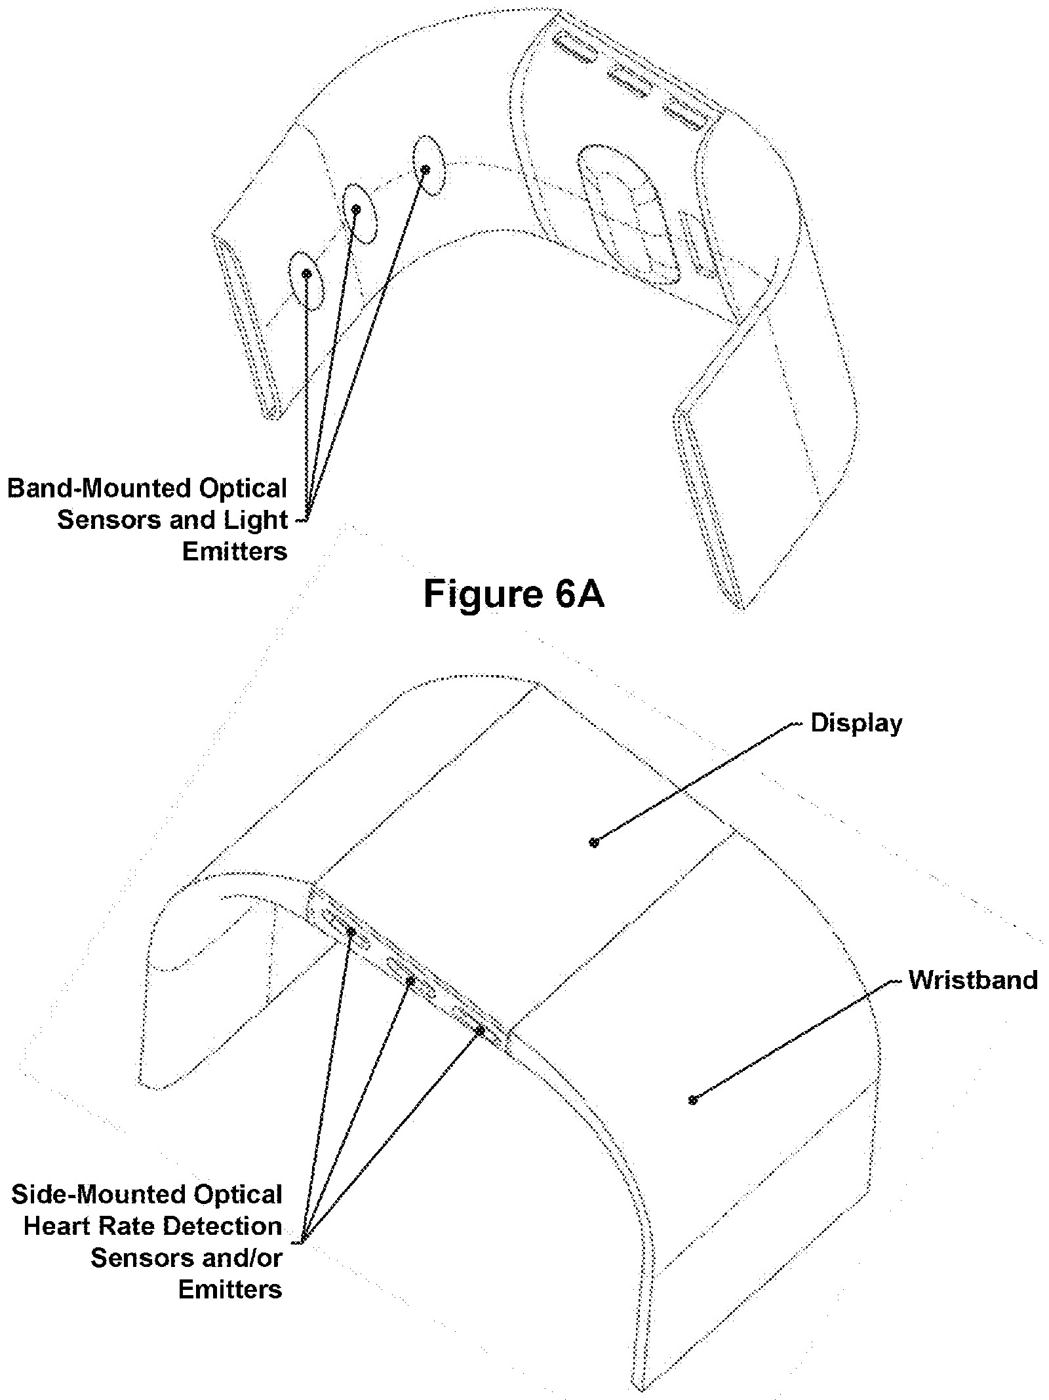
img/US-patent-9014790-9.jpg
