rafael1193/TFG-heart-rate-monitor/img/US-patent-9039614-5.jpg

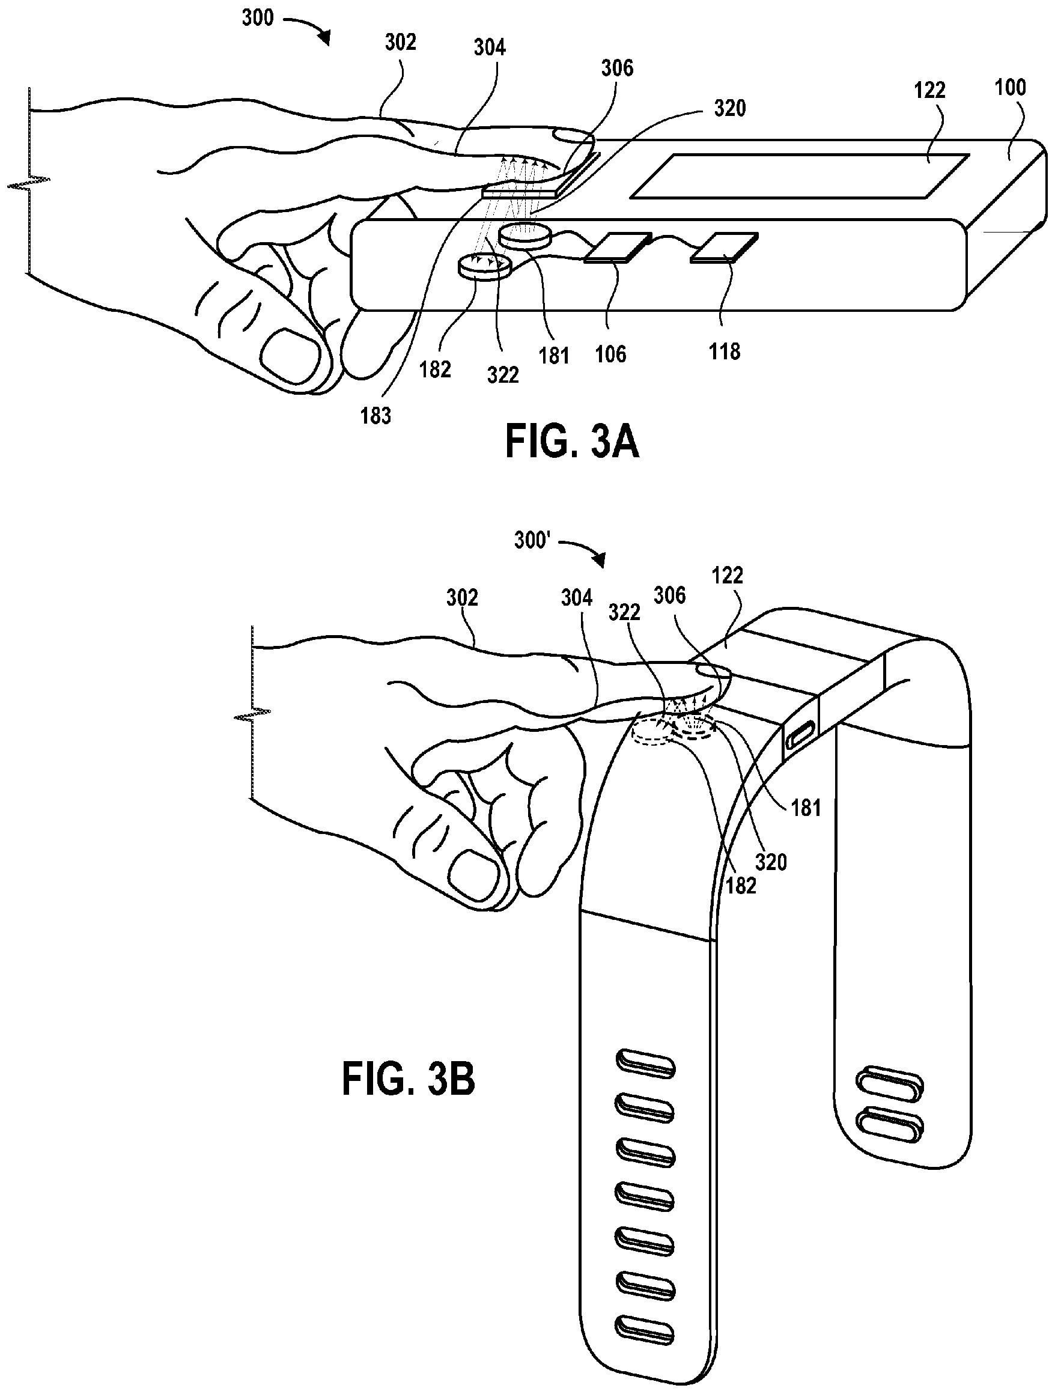
img/US-patent-9039614-5.jpg
