rafael1193/TFG-heart-rate-monitor/img/PPG-components-Reddy.png

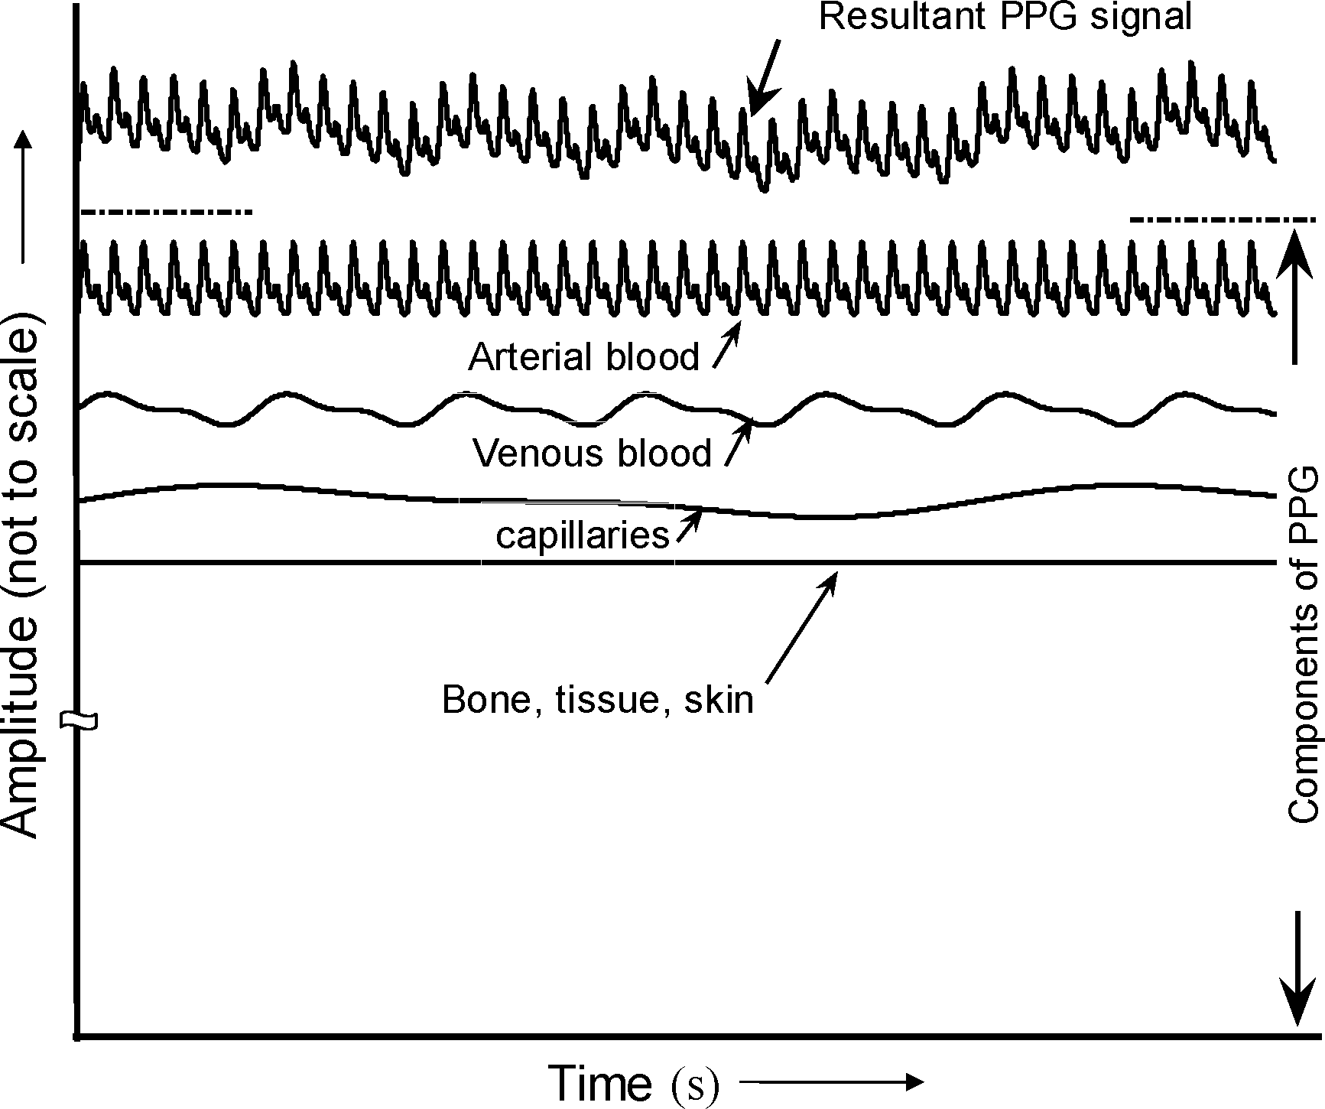
img/PPG-components-Reddy.png
