rafael1193/TFG-heart-rate-monitor/data/datos-test-validacion.ods

Sheet: Dinámico
Reposo | 70 | 69 |  | Pulsómetro/Cardiofrecuencímetro
Tiempo [s] | Pulsómetro | Cardiofrecuencímetro | Desviación Pulsómetro | Desviación Cardiofrecuencímetro
0 | 174 | 140 | 104 | 71
15 | 134 | 136 | 64 | 67
30 | 126 | 130 | 56 | 61
45 | 119 | 122 | 49 | 53
60 | 119 | 118 | 49 | 49
75 | 113 | 113 | 43 | 44
90 | 112 | 108 | 42 | 39
105 | 104 | 105 | 34 | 36
135 | 106 | 105 | 36 | 36
150 | 102 | 101 | 32 | 32
165 | 99 | 100 | 29 | 31
180 | 95 | 99 | 25 | 30
195 | 99 | 97 | 29 | 28
210 | 93 | 94 | 23 | 25
225 | 94 | 93 | 24 | 24

Sheet: Reposo
Tiempo [s] | Pulsómetro (PPG) [PPM] | Pulsómetro (ECG) [PPM]
0 | 67 | 68
15 | 66 | 67
30 | 72 | 66
45 | 70 | 71
60 | 67 | 71
75 | 71 | 68
90 | 67 | 71
120 | 79 | 68
135 | 70 | 70
 | Pulsómetro (PPG) [PPM] | Pulsómetro (ECG) [PPM]
Promedio | 70 | 69
Desviación tipica | 4,0138648596 | 1,9002923752
g | 8 | 8
n | 9 | 9
t student | 3,355 | 3,355
Error absoluto | 4,488838868 | 2,1251603062
 | 5 | 3
