rafael1193/TFG-heart-rate-monitor/circuitos/kicad/programador_pic.pdf

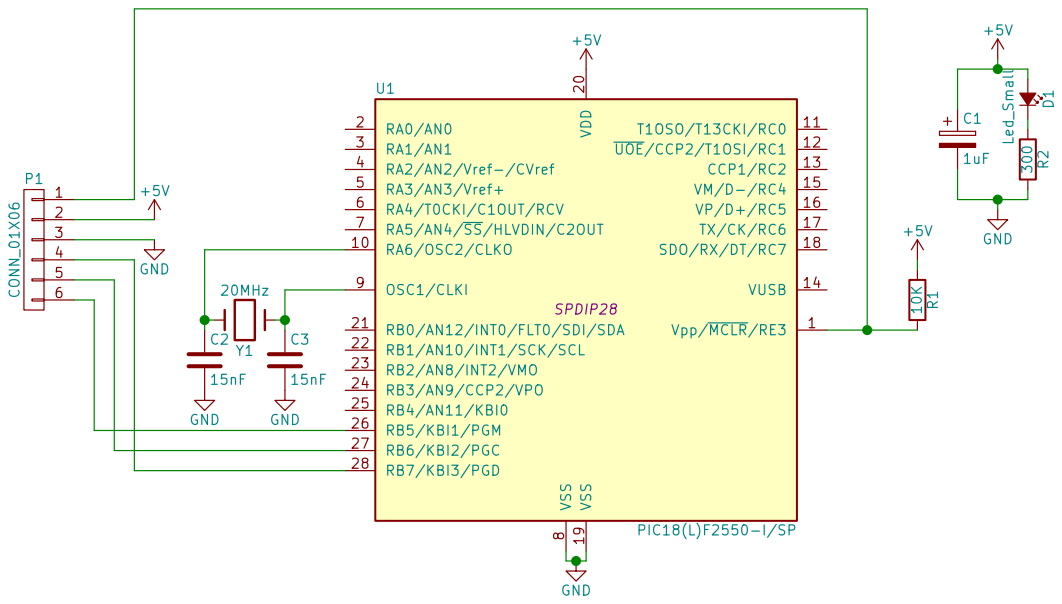
[picture p47: page 1]
