rafael1193/TFG-heart-rate-monitor/circuitos/eagle/pulsometro.brd

## EAGLE design circuitos/eagle/pulsometro.brd (2015-07-05)

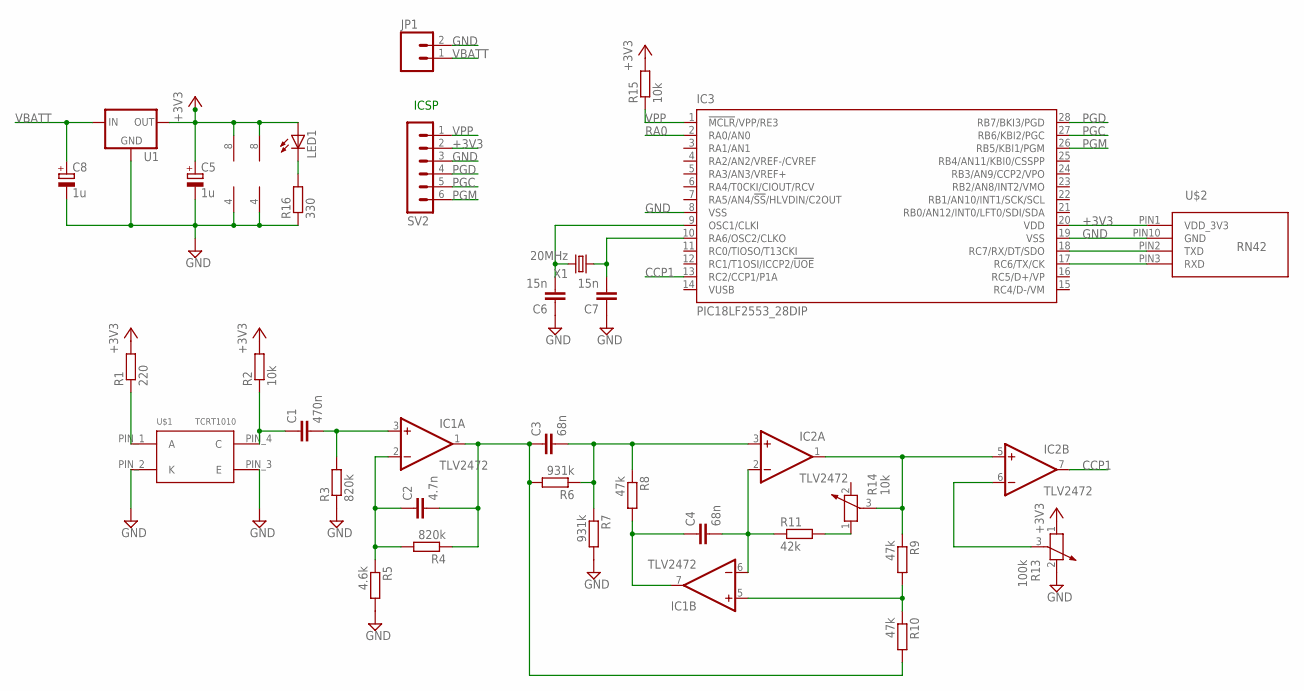
[picture p48: schematic pulsometro.sch]

Parts:
C1: 470n; C025-025X050
C2: 4.7n; C025-025X050
C3, C4: 68n; C025-025X050
C5, C8: 1u; E2,5-5
C6, C7: 15n; C025-025X050
IC1, IC2: TLV2472; DIL08
IC3: PIC18LF2553_28DIP; DIL28-3
JP1: M02PTH; 1X02
LED1: LED3MM
R1: 220; 0204/7
R2, R15: 10k; 0204/7
R3, R4: 820k; 0204/7
R5: 4.6k; 0204/7
R6, R7: 931k; 0204/7
R8, R9, R10: 47k; 0204/7
R11: 42k; 0204/7
R13: 100k; PT-10
R14: 10k; PT-10
R16: 330; 0204/7
SV2: MA06-1
U1: V_REG_78XXTO-92_UNTESTED; TO-92
U$1: TCRT1010
U$2: RN42; 2X10-2MMSOCKET
X1: 20MHz; HC49

Connections:
+3V3: C5.+, IC1.8 (V+), IC2.8 (V+), IC3.20 (VDD), LED1.A, R1.2, R2.2, R13.1, R15.2, SV2.2, U1.3 (OUT), U$2.PIN1 (VDD_3V3)
CCP1: IC2.7 (OUT), IC3.13 (RC2/CCP1/P1A)
GND: C5.-, C6.1, C7.1, C8.-, IC1.4 (V-), IC2.4 (V-), IC3.8 (VSS), IC3.19 (VSS), JP1.2, R3.1, R5.2, R7.2, R13.2, R16.1, SV2.3, U1.1 (GND), U$1.PIN_2 (K), U$1.PIN_3 (E), U$2.PIN10 (GND)
unnamed: R1.1, U$1.PIN_1 (A)
unnamed: C1.1, R2.1, U$1.PIN_4 (C)
unnamed: C2.1, IC1.2 (-IN), R4.2, R5.1
unnamed: C1.2, IC1.3 (+IN), R3.2
unnamed: C2.2, C3.1, IC1.1 (OUT), R4.1, R6.2, R10.2
unnamed: C3.2, IC2.3 (+IN), R6.1, R7.1, R8.1
unnamed: C4.1, IC1.7 (OUT), R8.2
unnamed: C4.2, IC1.6 (-IN), IC2.2 (-IN), R11.1
unnamed: R11.2, R14.1
unnamed: IC2.1 (OUT), IC2.5 (+IN), R9.1, R14.3
unnamed: IC1.5 (+IN), R9.2, R10.1
unnamed: IC2.6 (-IN), R13.3
unnamed: IC3.18 (RC7/RX/DT/SDO), U$2.PIN2 (TXD)
unnamed: IC3.17 (RC6/TX/CK), U$2.PIN3 (RXD)
unnamed: LED1.K (C), R16.2
unnamed: C7.2, IC3.10 (RA6/OSC2/CLKO), X1.1
unnamed: C6.2, IC3.9 (OSC1/CLKI), X1.2
PGC: IC3.27 (RB6/KBI2/PGC), SV2.5
PGD: IC3.28 (RB7/BKI3/PGD), SV2.4
PGM: IC3.26 (RB5/KBI1/PGM), SV2.6
RA0: IC3.2 (RA0/AN0)
VBATT: C8.+, JP1.1, U1.2 (IN)
VPP: IC3.1 (!MCLR!/VPP/RE3), R15.1, SV2.1

Notes on the sheet:
ICSP

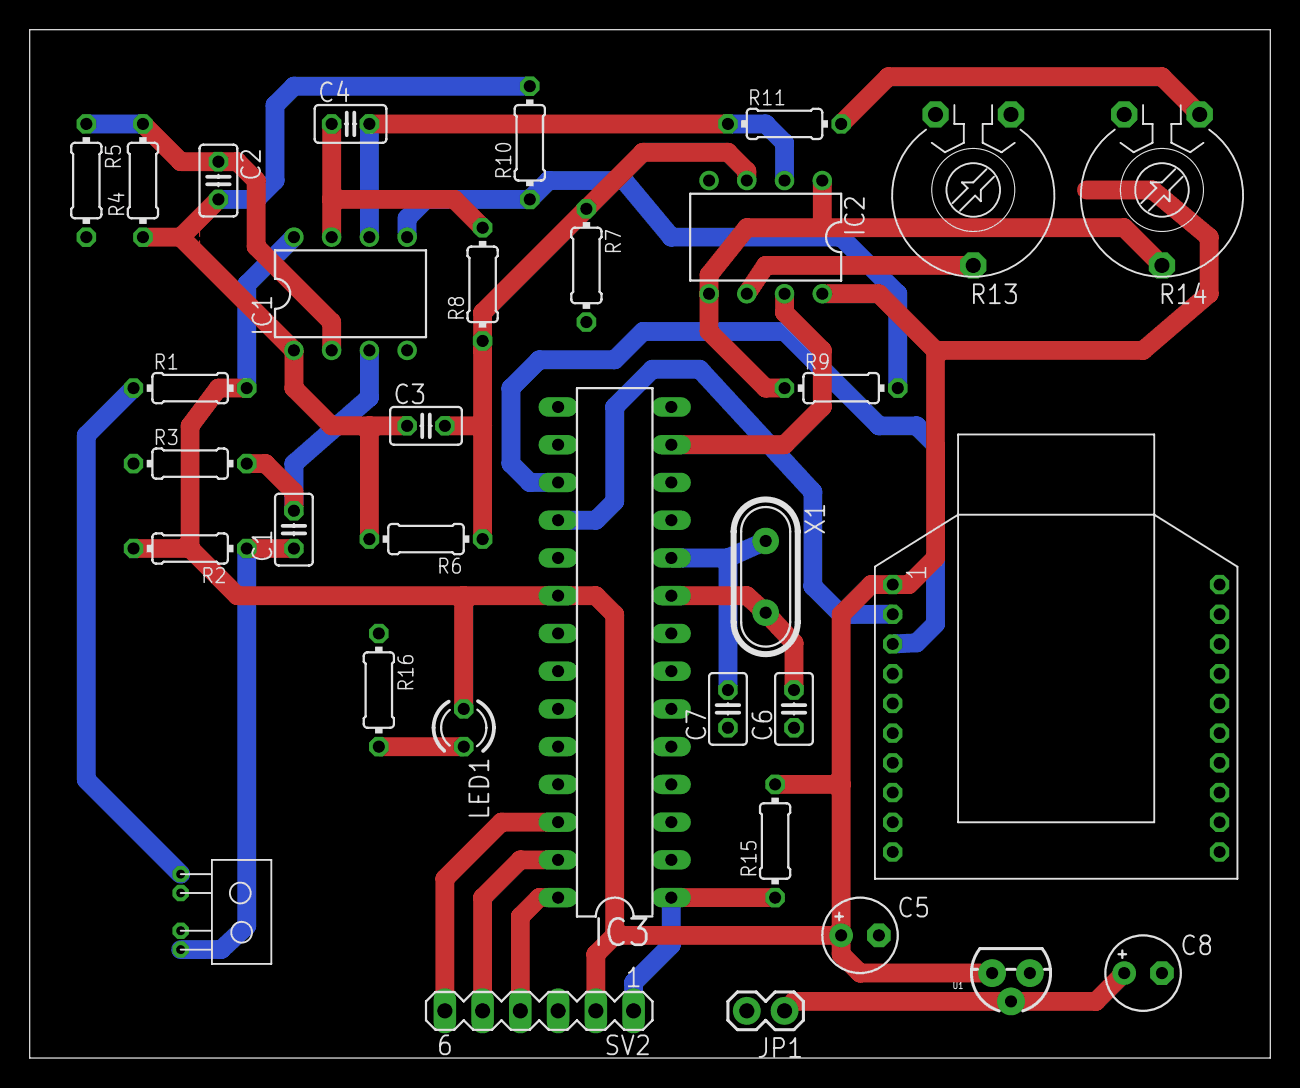
[picture p49: board pulsometro.brd from above]

Board: 2 copper layers, 83.5 x 69.2 mm, 33 parts (0 on the bottom side), 25 nets.
