rafael1193/TFG-heart-rate-monitor/src/pulsometro.X/main.c

/* Pulsómetro
 * Copyright (C) 2015 Rafael-Bailón Ruiz <rafaelbailon@ieee.org>
 *
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
 * You should have received a copy of the GNU General Public License
 * along with this program.  If not, see <http://www.gnu.org/licenses/>.
 */

/******************************************************************************/
/* Files to Include                                                           */
/******************************************************************************/

#if defined(__XC)
    #include <xc.h>        /* XC8 General Include File */
#elif defined(HI_TECH_C)
    #include <htc.h>       /* HiTech General Include File */
#elif defined(__18CXX)
    #include <p18cxxx.h>   /* C18 General Include File */
#endif

#if defined(__XC) || defined(HI_TECH_C)

#include <stdint.h>        /* For uint8_t definition */
#include <stdbool.h>       /* For true/false definition */
#include <usart.h>
#include <math.h>

#endif

#include "user.h"          /* User funct/params, such as InitApp */

/******************************************************************************/
/* User Global Variable Declaration                                           */
/******************************************************************************/

/* i.e. uint8_t <variable_name>; */

/******************************************************************************/
/* Main Program                                                               */
/******************************************************************************/

void main(void)
{
    InitApp();
    
    while(1) {
        if(send_value == true) {
            send_value = false;
            /* Computation formula:
             *
             * T(s) = period * 8 * 4 * 0.05e-6=
             *      = period * 1.6e-6
             * BPM = 60 / T
             */
            char byte_period = (char) round(60 / (period * 1.6e-6));
            period = 0;
            if(byte_period >= 40 && byte_period <= 200) {
                WriteUSART(byte_period);
            } else {
                WriteUSART(0);
            }
        }
    }
    
}
