rafael1193/TFG-heart-rate-monitor/(commit log)

2015-05-04 Enable and configure timer0 for 1s period pulse
2015-05-08 Measure period of input signal at pin 13.
    - Configure CCP module in "Capture" mode.
    - Configure Timer1 to measure time between CCP events
2015-06-11 Fix high-pass filter resistance vale
    Was 82K instead of 820K
    [acondicionamiento.sch]
2015-06-16 Move KiCad files to *kicad* folder
    [acondicionamiento.dsn, acondicionamiento.sch, programador_pic.sch]
2015-06-16 Add PCB made with eagle
    [pulsometro.brd, pulsometro.sch]
2015-06-24 Configure UART communication
2015-06-24 Send value over UART at interval
    A fixed value is sent for now. In the future, it is going be BPM value.
    [interrupts.c, main.c, user.h]
2015-06-25 Fix reset timer1 values before using them
    [interrupts.c]
2015-06-25 Several fixes in BPM calculation
    * BPM calculation formula was wrong and has been corrected.
    * Discard not valid _period_ values
    * Increase BPM value emission period
    [interrupts.c, main.c, user.h]
2015-06-26 Send 0 from pulsemeter when pulses are not in valid interval
    This helps android app to detect whether finger is put
2015-06-29 Reduce amplifier resistor
    [pulsometro.brd, pulsometro.sch]
2015-06-29 Add regulator to schematic and board
    [pulsometro.brd, pulsometro.sch]
2015-07-01 Update circuit
    * Remove transistor switch of TCRT1010 diode and change resistor value
    * Change LM358 op-amp to TLV2472
    [pulsometro.brd, pulsometro.sch]
2015-07-01 Add circuit image
2015-07-01 Fix voltage source value
    [pulsometro.brd, pulsometro.sch]
2015-07-01 Add circuit images
2015-07-04 Fix pic firmware build
    [main.c]
2015-07-04 Add validation test data
    [datos-test-validacion.ods]
2015-07-05 Include pcb in report
    [pulsometro.brd, pulsometro.sch]
2015-07-07 Add box to circuit
2015-07-07 Move PCB to annex
2015-07-07 Add simulations of filter stages
    [Filtro notch.csv, Filtro paso alta.csv, Filtro paso baja.csv, Filtros conjunto.csv, filtro-conjunto.sch, filtros.ods, notch.sch, paso-alta.sch]
2015-07-12 Update gerber files
